ForrestKang/fpga-line-laser-3d-measurement/report/ai_collaboration_records.md

# 智能体协作记录

以下保留任务片段、响应摘要、纠错过程和可复核产物；响应摘要用于说明执行思路，不作为逐字对话记录。

## 工程复现与参考结果比对

提示词片段：“软件跟固件配套核对清楚，测试也跑完整，再重新打包给我人工检查。”

响应摘要：先整理源码与恢复映射，再从解包目录执行测试，按接口合同检查帧身份、字段、顺序、单位与参考结果，保留错误输入和结果。

自我纠错：不能只凭输出非空判断正确，也不能排序后掩盖协议顺序变化。将输入、比较字段和容限写清楚，逐项区分结果差异、接口差异与运行环境问题。

可复核产物：[源码恢复入口](../build/restore_sources.py)、[完整软件测试](../sim/run_release_tests.py)、[软件与固件接口测试](../sim/test_release_pairing.py)和[通用工作流](../skill/readme.md)。

## 报告图形与交付包纠错

提示词片段：“帮我把代码修改好，还有我的报告中这一页pdf是什么情况。”

响应摘要：核对原始图形与PDF中的公式、编号和箭头，定位嵌入矢量图在导出器中的兼容问题；改用原图的高分辨率预览嵌入，保留配色、公式内容和测量数值，再渲染检查。

自我纠错：不能仅凭正文提取和缩略图判断PDF正确；需要查看最终页面的公式与文字。工程包也不能只保留程序文件，必须按提交指南同时带上仿真、实现报告、板端结果和复现脚本。

可复核产物：[技术报告](design_report.pdf)、[完整构建入口](../build/reproduce.py)、[验证汇总](release_validation.json)。

## 工作流与经验提炼

实际采用“输入与接口确认→参考模型/冻结结果→实现→差分与故障测试→解包复现→交付”的流程。独立子任务可以并行检查，集成和单板执行保持唯一负责人。智能体负责代码阅读、脚本组织与报告分析，位宽、缓存所有权、错误拒绝和时序结论由对应测试与工具报告确认。

通用技能从DMA等待与中断、缓存所有权、参考结果错序和性能计时混用中提炼；验证方法、效果与边界见[技能提炼](skill_development.md)和[技能入口](../skill/readme.md)。
