ForrestKang/fpga-line-laser-3d-measurement/board/historical_outputs/scan_models_20261031/astro_views.png

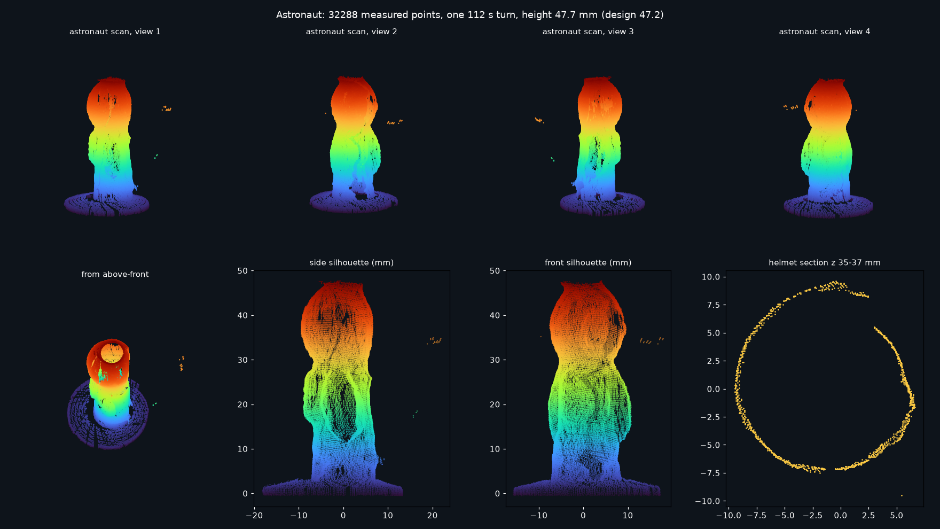
board/historical_outputs/scan_models_20261031/astro_views.png
