ForrestKang/fpga-line-laser-3d-measurement/board/historical_outputs/scan_models_20261031/meshes.png

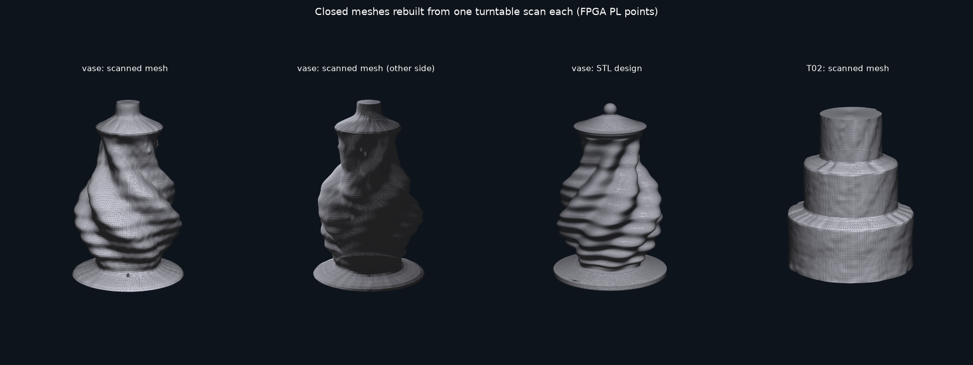
board/historical_outputs/scan_models_20261031/meshes.png
