ForrestKang/fpga-line-laser-3d-measurement/build/evidence/reports/cdc_constraint_inventory.txt

cam_fault_sync1 expected_D=1 actual_D=1
  DEST_D bd_i/processing_pipeline/inst/u_ip/u_core/cam_fault_sync1_reg/D
cam_fault_sync1 TIMED_D bd_i/processing_pipeline/inst/u_ip/u_core/cam_fault_sync1_reg/D Q=bd_i/processing_pipeline/inst/u_ip/u_core/cam_fault_reg/Q C=bd_i/processing_pipeline/inst/u_ip/u_core/cam_fault_reg/C
cam_fault_sync1 source_clock=cam_pclk destination_clock=clk_fpga_0  D=1 timed_D=1 source_Q=1  timing_start_C=1 constants=0 local_feedback=0  max_delay_ns=10 bus_skew=0
cam_fault_flags_sync1 expected_D=16 actual_D=16
  DEST_D bd_i/processing_pipeline/inst/u_ip/u_core/cam_fault_flags_sync1_reg[0]/D
  DEST_D bd_i/processing_pipeline/inst/u_ip/u_core/cam_fault_flags_sync1_reg[10]/D
  DEST_D bd_i/processing_pipeline/inst/u_ip/u_core/cam_fault_flags_sync1_reg[11]/D
  DEST_D bd_i/processing_pipeline/inst/u_ip/u_core/cam_fault_flags_sync1_reg[12]/D
  DEST_D bd_i/processing_pipeline/inst/u_ip/u_core/cam_fault_flags_sync1_reg[13]/D
  DEST_D bd_i/processing_pipeline/inst/u_ip/u_core/cam_fault_flags_sync1_reg[14]/D
  DEST_D bd_i/processing_pipeline/inst/u_ip/u_core/cam_fault_flags_sync1_reg[15]/D
  DEST_D bd_i/processing_pipeline/inst/u_ip/u_core/cam_fault_flags_sync1_reg[1]/D
  DEST_D bd_i/processing_pipeline/inst/u_ip/u_core/cam_fault_flags_sync1_reg[2]/D
  DEST_D bd_i/processing_pipeline/inst/u_ip/u_core/cam_fault_flags_sync1_reg[3]/D
  DEST_D bd_i/processing_pipeline/inst/u_ip/u_core/cam_fault_flags_sync1_reg[4]/D
  DEST_D bd_i/processing_pipeline/inst/u_ip/u_core/cam_fault_flags_sync1_reg[5]/D
  DEST_D bd_i/processing_pipeline/inst/u_ip/u_core/cam_fault_flags_sync1_reg[6]/D
  DEST_D bd_i/processing_pipeline/inst/u_ip/u_core/cam_fault_flags_sync1_reg[7]/D
  DEST_D bd_i/processing_pipeline/inst/u_ip/u_core/cam_fault_flags_sync1_reg[8]/D
  DEST_D bd_i/processing_pipeline/inst/u_ip/u_core/cam_fault_flags_sync1_reg[9]/D
cam_fault_flags_sync1 CONSTANT_D bd_i/processing_pipeline/inst/u_ip/u_core/cam_fault_flags_sync1_reg[0]/D GND bd_i/processing_pipeline/inst/u_ip/u_core/GND/G
cam_fault_flags_sync1 CONSTANT_D bd_i/processing_pipeline/inst/u_ip/u_core/cam_fault_flags_sync1_reg[10]/D GND bd_i/processing_pipeline/inst/u_ip/u_core/GND/G
cam_fault_flags_sync1 CONSTANT_D bd_i/processing_pipeline/inst/u_ip/u_core/cam_fault_flags_sync1_reg[11]/D GND bd_i/processing_pipeline/inst/u_ip/u_core/GND/G
cam_fault_flags_sync1 CONSTANT_D bd_i/processing_pipeline/inst/u_ip/u_core/cam_fault_flags_sync1_reg[12]/D GND bd_i/processing_pipeline/inst/u_ip/u_core/GND/G
cam_fault_flags_sync1 CONSTANT_D bd_i/processing_pipeline/inst/u_ip/u_core/cam_fault_flags_sync1_reg[13]/D GND bd_i/processing_pipeline/inst/u_ip/u_core/GND/G
cam_fault_flags_sync1 CONSTANT_D bd_i/processing_pipeline/inst/u_ip/u_core/cam_fault_flags_sync1_reg[14]/D GND bd_i/processing_pipeline/inst/u_ip/u_core/GND/G
cam_fault_flags_sync1 CONSTANT_D bd_i/processing_pipeline/inst/u_ip/u_core/cam_fault_flags_sync1_reg[15]/D GND bd_i/processing_pipeline/inst/u_ip/u_core/GND/G
cam_fault_flags_sync1 TIMED_D bd_i/processing_pipeline/inst/u_ip/u_core/cam_fault_flags_sync1_reg[1]/D Q=bd_i/processing_pipeline/inst/u_ip/u_core/cam_fault_flags_reg[1]/Q C=bd_i/processing_pipeline/inst/u_ip/u_core/cam_fault_flags_reg[1]/C
cam_fault_flags_sync1 TIMED_D bd_i/processing_pipeline/inst/u_ip/u_core/cam_fault_flags_sync1_reg[2]/D Q=bd_i/processing_pipeline/inst/u_ip/u_core/cam_fault_flags_reg[2]/Q C=bd_i/processing_pipeline/inst/u_ip/u_core/cam_fault_flags_reg[2]/C
cam_fault_flags_sync1 TIMED_D bd_i/processing_pipeline/inst/u_ip/u_core/cam_fault_flags_sync1_reg[3]/D Q=bd_i/processing_pipeline/inst/u_ip/u_core/cam_fault_flags_reg[3]/Q C=bd_i/processing_pipeline/inst/u_ip/u_core/cam_fault_flags_reg[3]/C
cam_fault_flags_sync1 CONSTANT_D bd_i/processing_pipeline/inst/u_ip/u_core/cam_fault_flags_sync1_reg[4]/D GND bd_i/processing_pipeline/inst/u_ip/u_core/GND/G
cam_fault_flags_sync1 TIMED_D bd_i/processing_pipeline/inst/u_ip/u_core/cam_fault_flags_sync1_reg[5]/D Q=bd_i/processing_pipeline/inst/u_ip/u_core/cam_fault_flags_reg[5]/Q C=bd_i/processing_pipeline/inst/u_ip/u_core/cam_fault_flags_reg[5]/C
cam_fault_flags_sync1 CONSTANT_D bd_i/processing_pipeline/inst/u_ip/u_core/cam_fault_flags_sync1_reg[6]/D GND bd_i/processing_pipeline/inst/u_ip/u_core/GND/G
cam_fault_flags_sync1 CONSTANT_D bd_i/processing_pipeline/inst/u_ip/u_core/cam_fault_flags_sync1_reg[7]/D GND bd_i/processing_pipeline/inst/u_ip/u_core/GND/G
cam_fault_flags_sync1 CONSTANT_D bd_i/processing_pipeline/inst/u_ip/u_core/cam_fault_flags_sync1_reg[8]/D GND bd_i/processing_pipeline/inst/u_ip/u_core/GND/G
cam_fault_flags_sync1 CONSTANT_D bd_i/processing_pipeline/inst/u_ip/u_core/cam_fault_flags_sync1_reg[9]/D GND bd_i/processing_pipeline/inst/u_ip/u_core/GND/G
cam_fault_flags_sync1 source_clock=cam_pclk destination_clock=clk_fpga_0  D=16 timed_D=4 source_Q=4  timing_start_C=4 constants=12 local_feedback=0  max_delay_ns=10 bus_skew=10
cam_frame_count_sync1 expected_D=16 actual_D=16
  DEST_D bd_i/processing_pipeline/inst/u_ip/u_core/cam_frame_count_sync1_reg[0]/D
  DEST_D bd_i/processing_pipeline/inst/u_ip/u_core/cam_frame_count_sync1_reg[10]/D
  DEST_D bd_i/processing_pipeline/inst/u_ip/u_core/cam_frame_count_sync1_reg[11]/D
  DEST_D bd_i/processing_pipeline/inst/u_ip/u_core/cam_frame_count_sync1_reg[12]/D
  DEST_D bd_i/processing_pipeline/inst/u_ip/u_core/cam_frame_count_sync1_reg[13]/D
  DEST_D bd_i/processing_pipeline/inst/u_ip/u_core/cam_frame_count_sync1_reg[14]/D
  DEST_D bd_i/processing_pipeline/inst/u_ip/u_core/cam_frame_count_sync1_reg[15]/D
  DEST_D bd_i/processing_pipeline/inst/u_ip/u_core/cam_frame_count_sync1_reg[1]/D
  DEST_D bd_i/processing_pipeline/inst/u_ip/u_core/cam_frame_count_sync1_reg[2]/D
  DEST_D bd_i/processing_pipeline/inst/u_ip/u_core/cam_frame_count_sync1_reg[3]/D
  DEST_D bd_i/processing_pipeline/inst/u_ip/u_core/cam_frame_count_sync1_reg[4]/D
  DEST_D bd_i/processing_pipeline/inst/u_ip/u_core/cam_frame_count_sync1_reg[5]/D
  DEST_D bd_i/processing_pipeline/inst/u_ip/u_core/cam_frame_count_sync1_reg[6]/D
  DEST_D bd_i/processing_pipeline/inst/u_ip/u_core/cam_frame_count_sync1_reg[7]/D
  DEST_D bd_i/processing_pipeline/inst/u_ip/u_core/cam_frame_count_sync1_reg[8]/D
  DEST_D bd_i/processing_pipeline/inst/u_ip/u_core/cam_frame_count_sync1_reg[9]/D
cam_frame_count_sync1 TIMED_D bd_i/processing_pipeline/inst/u_ip/u_core/cam_frame_count_sync1_reg[0]/D Q=bd_i/processing_pipeline/inst/u_ip/u_core/cam_frame_count_gray_reg[0]/Q C=bd_i/processing_pipeline/inst/u_ip/u_core/cam_frame_count_gray_reg[0]/C
cam_frame_count_sync1 TIMED_D bd_i/processing_pipeline/inst/u_ip/u_core/cam_frame_count_sync1_reg[10]/D Q=bd_i/processing_pipeline/inst/u_ip/u_core/cam_frame_count_gray_reg[10]/Q C=bd_i/processing_pipeline/inst/u_ip/u_core/cam_frame_count_gray_reg[10]/C
cam_frame_count_sync1 TIMED_D bd_i/processing_pipeline/inst/u_ip/u_core/cam_frame_count_sync1_reg[11]/D Q=bd_i/processing_pipeline/inst/u_ip/u_core/cam_frame_count_gray_reg[11]/Q C=bd_i/processing_pipeline/inst/u_ip/u_core/cam_frame_count_gray_reg[11]/C
cam_frame_count_sync1 TIMED_D bd_i/processing_pipeline/inst/u_ip/u_core/cam_frame_count_sync1_reg[12]/D Q=bd_i/processing_pipeline/inst/u_ip/u_core/cam_frame_count_gray_reg[12]/Q C=bd_i/processing_pipeline/inst/u_ip/u_core/cam_frame_count_gray_reg[12]/C
cam_frame_count_sync1 TIMED_D bd_i/processing_pipeline/inst/u_ip/u_core/cam_frame_count_sync1_reg[13]/D Q=bd_i/processing_pipeline/inst/u_ip/u_core/cam_frame_count_gray_reg[13]/Q C=bd_i/processing_pipeline/inst/u_ip/u_core/cam_frame_count_gray_reg[13]/C
cam_frame_count_sync1 TIMED_D bd_i/processing_pipeline/inst/u_ip/u_core/cam_frame_count_sync1_reg[14]/D Q=bd_i/processing_pipeline/inst/u_ip/u_core/cam_frame_count_gray_reg[14]/Q C=bd_i/processing_pipeline/inst/u_ip/u_core/cam_frame_count_gray_reg[14]/C
cam_frame_count_sync1 TIMED_D bd_i/processing_pipeline/inst/u_ip/u_core/cam_frame_count_sync1_reg[15]/D Q=bd_i/processing_pipeline/inst/u_ip/u_core/cam_frame_count_gray_reg[15]/Q C=bd_i/processing_pipeline/inst/u_ip/u_core/cam_frame_count_gray_reg[15]/C
cam_frame_count_sync1 TIMED_D bd_i/processing_pipeline/inst/u_ip/u_core/cam_frame_count_sync1_reg[1]/D Q=bd_i/processing_pipeline/inst/u_ip/u_core/cam_frame_count_gray_reg[1]/Q C=bd_i/processing_pipeline/inst/u_ip/u_core/cam_frame_count_gray_reg[1]/C
cam_frame_count_sync1 TIMED_D bd_i/processing_pipeline/inst/u_ip/u_core/cam_frame_count_sync1_reg[2]/D Q=bd_i/processing_pipeline/inst/u_ip/u_core/cam_frame_count_gray_reg[2]/Q C=bd_i/processing_pipeline/inst/u_ip/u_core/cam_frame_count_gray_reg[2]/C
cam_frame_count_sync1 TIMED_D bd_i/processing_pipeline/inst/u_ip/u_core/cam_frame_count_sync1_reg[3]/D Q=bd_i/processing_pipeline/inst/u_ip/u_core/cam_frame_count_gray_reg[3]/Q C=bd_i/processing_pipeline/inst/u_ip/u_core/cam_frame_count_gray_reg[3]/C
cam_frame_count_sync1 TIMED_D bd_i/processing_pipeline/inst/u_ip/u_core/cam_frame_count_sync1_reg[4]/D Q=bd_i/processing_pipeline/inst/u_ip/u_core/cam_frame_count_gray_reg[4]/Q C=bd_i/processing_pipeline/inst/u_ip/u_core/cam_frame_count_gray_reg[4]/C
cam_frame_count_sync1 TIMED_D bd_i/processing_pipeline/inst/u_ip/u_core/cam_frame_count_sync1_reg[5]/D Q=bd_i/processing_pipeline/inst/u_ip/u_core/cam_frame_count_gray_reg[5]/Q C=bd_i/processing_pipeline/inst/u_ip/u_core/cam_frame_count_gray_reg[5]/C
cam_frame_count_sync1 TIMED_D bd_i/processing_pipeline/inst/u_ip/u_core/cam_frame_count_sync1_reg[6]/D Q=bd_i/processing_pipeline/inst/u_ip/u_core/cam_frame_count_gray_reg[6]/Q C=bd_i/processing_pipeline/inst/u_ip/u_core/cam_frame_count_gray_reg[6]/C
cam_frame_count_sync1 TIMED_D bd_i/processing_pipeline/inst/u_ip/u_core/cam_frame_count_sync1_reg[7]/D Q=bd_i/processing_pipeline/inst/u_ip/u_core/cam_frame_count_gray_reg[7]/Q C=bd_i/processing_pipeline/inst/u_ip/u_core/cam_frame_count_gray_reg[7]/C
cam_frame_count_sync1 TIMED_D bd_i/processing_pipeline/inst/u_ip/u_core/cam_frame_count_sync1_reg[8]/D Q=bd_i/processing_pipeline/inst/u_ip/u_core/cam_frame_count_gray_reg[8]/Q C=bd_i/processing_pipeline/inst/u_ip/u_core/cam_frame_count_gray_reg[8]/C
cam_frame_count_sync1 TIMED_D bd_i/processing_pipeline/inst/u_ip/u_core/cam_frame_count_sync1_reg[9]/D Q=bd_i/processing_pipeline/inst/u_ip/u_core/cam_frame_count_gray_reg[9]/Q C=bd_i/processing_pipeline/inst/u_ip/u_core/cam_frame_count_gray_reg[9]/C
cam_frame_count_sync1 source_clock=cam_pclk destination_clock=clk_fpga_0  D=16 timed_D=16 source_Q=16  timing_start_C=16 constants=0 local_feedback=0  max_delay_ns=10 bus_skew=10
geometry_toggle_sync1 expected_D=1 actual_D=1
  DEST_D bd_i/processing_pipeline/inst/u_ip/u_core/geometry_toggle_sync1_reg/D
geometry_toggle_sync1 TIMED_D bd_i/processing_pipeline/inst/u_ip/u_core/geometry_toggle_sync1_reg/D Q=bd_i/processing_pipeline/inst/u_ip/u_core/cam_geometry_toggle_reg/Q C=bd_i/processing_pipeline/inst/u_ip/u_core/cam_geometry_toggle_reg/C
geometry_toggle_sync1 source_clock=cam_pclk destination_clock=clk_fpga_0  D=1 timed_D=1 source_Q=1  timing_start_C=1 constants=0 local_feedback=0  max_delay_ns=10 bus_skew=0
geometry_line_sync1 expected_D=32 actual_D=32
  DEST_D bd_i/processing_pipeline/inst/u_ip/u_core/geometry_line_sync1_reg[0]/D
  DEST_D bd_i/processing_pipeline/inst/u_ip/u_core/geometry_line_sync1_reg[10]/D
  DEST_D bd_i/processing_pipeline/inst/u_ip/u_core/geometry_line_sync1_reg[11]/D
  DEST_D bd_i/processing_pipeline/inst/u_ip/u_core/geometry_line_sync1_reg[12]/D
  DEST_D bd_i/processing_pipeline/inst/u_ip/u_core/geometry_line_sync1_reg[13]/D
  DEST_D bd_i/processing_pipeline/inst/u_ip/u_core/geometry_line_sync1_reg[14]/D
  DEST_D bd_i/processing_pipeline/inst/u_ip/u_core/geometry_line_sync1_reg[15]/D
  DEST_D bd_i/processing_pipeline/inst/u_ip/u_core/geometry_line_sync1_reg[16]/D
  DEST_D bd_i/processing_pipeline/inst/u_ip/u_core/geometry_line_sync1_reg[17]/D
  DEST_D bd_i/processing_pipeline/inst/u_ip/u_core/geometry_line_sync1_reg[18]/D
  DEST_D bd_i/processing_pipeline/inst/u_ip/u_core/geometry_line_sync1_reg[19]/D
  DEST_D bd_i/processing_pipeline/inst/u_ip/u_core/geometry_line_sync1_reg[1]/D
  DEST_D bd_i/processing_pipeline/inst/u_ip/u_core/geometry_line_sync1_reg[20]/D
  DEST_D bd_i/processing_pipeline/inst/u_ip/u_core/geometry_line_sync1_reg[21]/D
  DEST_D bd_i/processing_pipeline/inst/u_ip/u_core/geometry_line_sync1_reg[22]/D
  DEST_D bd_i/processing_pipeline/inst/u_ip/u_core/geometry_line_sync1_reg[23]/D
  DEST_D bd_i/processing_pipeline/inst/u_ip/u_core/geometry_line_sync1_reg[24]/D
  DEST_D bd_i/processing_pipeline/inst/u_ip/u_core/geometry_line_sync1_reg[25]/D
  DEST_D bd_i/processing_pipeline/inst/u_ip/u_core/geometry_line_sync1_reg[26]/D
  DEST_D bd_i/processing_pipeline/inst/u_ip/u_core/geometry_line_sync1_reg[27]/D
  DEST_D bd_i/processing_pipeline/inst/u_ip/u_core/geometry_line_sync1_reg[28]/D
  DEST_D bd_i/processing_pipeline/inst/u_ip/u_core/geometry_line_sync1_reg[29]/D
  DEST_D bd_i/processing_pipeline/inst/u_ip/u_core/geometry_line_sync1_reg[2]/D
  DEST_D bd_i/processing_pipeline/inst/u_ip/u_core/geometry_line_sync1_reg[30]/D
  DEST_D bd_i/processing_pipeline/inst/u_ip/u_core/geometry_line_sync1_reg[31]/D
  DEST_D bd_i/processing_pipeline/inst/u_ip/u_core/geometry_line_sync1_reg[3]/D
  DEST_D bd_i/processing_pipeline/inst/u_ip/u_core/geometry_line_sync1_reg[4]/D
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
geometry_line_sync1 TIMED_D bd_i/processing_pipeline/inst/u_ip/u_core/geometry_line_sync1_reg[5]/D Q=bd_i/processing_pipeline/inst/u_ip/u_core/cam_line_mailbox_reg[5]/Q C=bd_i/processing_pipeline/inst/u_ip/u_core/cam_line_mailbox_reg[5]/C
geometry_line_sync1 TIMED_D bd_i/processing_pipeline/inst/u_ip/u_core/geometry_line_sync1_reg[6]/D Q=bd_i/processing_pipeline/inst/u_ip/u_core/cam_line_mailbox_reg[6]/Q C=bd_i/processing_pipeline/inst/u_ip/u_core/cam_line_mailbox_reg[6]/C
geometry_line_sync1 TIMED_D bd_i/processing_pipeline/inst/u_ip/u_core/geometry_line_sync1_reg[7]/D Q=bd_i/processing_pipeline/inst/u_ip/u_core/cam_line_mailbox_reg[7]/Q C=bd_i/processing_pipeline/inst/u_ip/u_core/cam_line_mailbox_reg[7]/C
geometry_line_sync1 TIMED_D bd_i/processing_pipeline/inst/u_ip/u_core/geometry_line_sync1_reg[8]/D Q=bd_i/processing_pipeline/inst/u_ip/u_core/cam_line_mailbox_reg[8]/Q C=bd_i/processing_pipeline/inst/u_ip/u_core/cam_line_mailbox_reg[8]/C
geometry_line_sync1 TIMED_D bd_i/processing_pipeline/inst/u_ip/u_core/geometry_line_sync1_reg[9]/D Q=bd_i/processing_pipeline/inst/u_ip/u_core/cam_line_mailbox_reg[9]/Q C=bd_i/processing_pipeline/inst/u_ip/u_core/cam_line_mailbox_reg[9]/C
geometry_line_sync1 source_clock=cam_pclk destination_clock=clk_fpga_0  D=32 timed_D=32 source_Q=32  timing_start_C=32 constants=0 local_feedback=0  max_delay_ns=10 bus_skew=10
geometry_frame_sync1 expected_D=11 actual_D=11
  DEST_D bd_i/processing_pipeline/inst/u_ip/u_core/geometry_frame_sync1_reg[0]/D
  DEST_D bd_i/processing_pipeline/inst/u_ip/u_core/geometry_frame_sync1_reg[10]/D
  DEST_D bd_i/processing_pipeline/inst/u_ip/u_core/geometry_frame_sync1_reg[1]/D
  DEST_D bd_i/processing_pipeline/inst/u_ip/u_core/geometry_frame_sync1_reg[2]/D
  DEST_D bd_i/processing_pipeline/inst/u_ip/u_core/geometry_frame_sync1_reg[3]/D
  DEST_D bd_i/processing_pipeline/inst/u_ip/u_core/geometry_frame_sync1_reg[4]/D
  DEST_D bd_i/processing_pipeline/inst/u_ip/u_core/geometry_frame_sync1_reg[5]/D
  DEST_D bd_i/processing_pipeline/inst/u_ip/u_core/geometry_frame_sync1_reg[6]/D
  DEST_D bd_i/processing_pipeline/inst/u_ip/u_core/geometry_frame_sync1_reg[7]/D
  DEST_D bd_i/processing_pipeline/inst/u_ip/u_core/geometry_frame_sync1_reg[8]/D
  DEST_D bd_i/processing_pipeline/inst/u_ip/u_core/geometry_frame_sync1_reg[9]/D
geometry_frame_sync1 TIMED_D bd_i/processing_pipeline/inst/u_ip/u_core/geometry_frame_sync1_reg[0]/D Q=bd_i/processing_pipeline/inst/u_ip/u_core/cam_frame_lines_mailbox_reg[0]/Q C=bd_i/processing_pipeline/inst/u_ip/u_core/cam_frame_lines_mailbox_reg[0]/C
geometry_frame_sync1 TIMED_D bd_i/processing_pipeline/inst/u_ip/u_core/geometry_frame_sync1_reg[10]/D Q=bd_i/processing_pipeline/inst/u_ip/u_core/cam_frame_lines_mailbox_reg[10]/Q C=bd_i/processing_pipeline/inst/u_ip/u_core/cam_frame_lines_mailbox_reg[10]/C
geometry_frame_sync1 TIMED_D bd_i/processing_pipeline/inst/u_ip/u_core/geometry_frame_sync1_reg[1]/D Q=bd_i/processing_pipeline/inst/u_ip/u_core/cam_frame_lines_mailbox_reg[1]/Q C=bd_i/processing_pipeline/inst/u_ip/u_core/cam_frame_lines_mailbox_reg[1]/C
geometry_frame_sync1 TIMED_D bd_i/processing_pipeline/inst/u_ip/u_core/geometry_frame_sync1_reg[2]/D Q=bd_i/processing_pipeline/inst/u_ip/u_core/cam_frame_lines_mailbox_reg[2]/Q C=bd_i/processing_pipeline/inst/u_ip/u_core/cam_frame_lines_mailbox_reg[2]/C
geometry_frame_sync1 TIMED_D bd_i/processing_pipeline/inst/u_ip/u_core/geometry_frame_sync1_reg[3]/D Q=bd_i/processing_pipeline/inst/u_ip/u_core/cam_frame_lines_mailbox_reg[3]/Q C=bd_i/processing_pipeline/inst/u_ip/u_core/cam_frame_lines_mailbox_reg[3]/C
geometry_frame_sync1 TIMED_D bd_i/processing_pipeline/inst/u_ip/u_core/geometry_frame_sync1_reg[4]/D Q=bd_i/processing_pipeline/inst/u_ip/u_core/cam_frame_lines_mailbox_reg[4]/Q C=bd_i/processing_pipeline/inst/u_ip/u_core/cam_frame_lines_mailbox_reg[4]/C
geometry_frame_sync1 TIMED_D bd_i/processing_pipeline/inst/u_ip/u_core/geometry_frame_sync1_reg[5]/D Q=bd_i/processing_pipeline/inst/u_ip/u_core/cam_frame_lines_mailbox_reg[5]/Q C=bd_i/processing_pipeline/inst/u_ip/u_core/cam_frame_lines_mailbox_reg[5]/C
geometry_frame_sync1 TIMED_D bd_i/processing_pipeline/inst/u_ip/u_core/geometry_frame_sync1_reg[6]/D Q=bd_i/processing_pipeline/inst/u_ip/u_core/cam_frame_lines_mailbox_reg[6]/Q C=bd_i/processing_pipeline/inst/u_ip/u_core/cam_frame_lines_mailbox_reg[6]/C
geometry_frame_sync1 TIMED_D bd_i/processing_pipeline/inst/u_ip/u_core/geometry_frame_sync1_reg[7]/D Q=bd_i/processing_pipeline/inst/u_ip/u_core/cam_frame_lines_mailbox_reg[7]/Q C=bd_i/processing_pipeline/inst/u_ip/u_core/cam_frame_lines_mailbox_reg[7]/C
geometry_frame_sync1 TIMED_D bd_i/processing_pipeline/inst/u_ip/u_core/geometry_frame_sync1_reg[8]/D Q=bd_i/processing_pipeline/inst/u_ip/u_core/cam_frame_lines_mailbox_reg[8]/Q C=bd_i/processing_pipeline/inst/u_ip/u_core/cam_frame_lines_mailbox_reg[8]/C
geometry_frame_sync1 TIMED_D bd_i/processing_pipeline/inst/u_ip/u_core/geometry_frame_sync1_reg[9]/D Q=bd_i/processing_pipeline/inst/u_ip/u_core/cam_frame_lines_mailbox_reg[9]/Q C=bd_i/processing_pipeline/inst/u_ip/u_core/cam_frame_lines_mailbox_reg[9]/C
geometry_frame_sync1 source_clock=cam_pclk destination_clock=clk_fpga_0  D=11 timed_D=11 source_Q=11  timing_start_C=11 constants=0 local_feedback=0  max_delay_ns=10 bus_skew=10
geometry_eof_sync1 expected_D=5 actual_D=5
  DEST_D bd_i/processing_pipeline/inst/u_ip/u_core/geometry_eof_sync1_reg[0]/D
  DEST_D bd_i/processing_pipeline/inst/u_ip/u_core/geometry_eof_sync1_reg[1]/D
  DEST_D bd_i/processing_pipeline/inst/u_ip/u_core/geometry_eof_sync1_reg[2]/D
  DEST_D bd_i/processing_pipeline/inst/u_ip/u_core/geometry_eof_sync1_reg[3]/D
  DEST_D bd_i/processing_pipeline/inst/u_ip/u_core/geometry_eof_sync1_reg[4]/D
geometry_eof_sync1 TIMED_D bd_i/processing_pipeline/inst/u_ip/u_core/geometry_eof_sync1_reg[0]/D Q=bd_i/processing_pipeline/inst/u_ip/u_core/cam_eof_errors_mailbox_reg[0]/Q C=bd_i/processing_pipeline/inst/u_ip/u_core/cam_eof_errors_mailbox_reg[0]/C
geometry_eof_sync1 TIMED_D bd_i/processing_pipeline/inst/u_ip/u_core/geometry_eof_sync1_reg[1]/D Q=bd_i/processing_pipeline/inst/u_ip/u_core/cam_eof_errors_mailbox_reg[1]/Q C=bd_i/processing_pipeline/inst/u_ip/u_core/cam_eof_errors_mailbox_reg[1]/C
geometry_eof_sync1 TIMED_D bd_i/processing_pipeline/inst/u_ip/u_core/geometry_eof_sync1_reg[2]/D Q=bd_i/processing_pipeline/inst/u_ip/u_core/cam_eof_errors_mailbox_reg[2]/Q C=bd_i/processing_pipeline/inst/u_ip/u_core/cam_eof_errors_mailbox_reg[2]/C
geometry_eof_sync1 TIMED_D bd_i/processing_pipeline/inst/u_ip/u_core/geometry_eof_sync1_reg[3]/D Q=bd_i/processing_pipeline/inst/u_ip/u_core/cam_eof_errors_mailbox_reg[3]/Q C=bd_i/processing_pipeline/inst/u_ip/u_core/cam_eof_errors_mailbox_reg[3]/C
geometry_eof_sync1 TIMED_D bd_i/processing_pipeline/inst/u_ip/u_core/geometry_eof_sync1_reg[4]/D Q=bd_i/processing_pipeline/inst/u_ip/u_core/cam_eof_errors_mailbox_reg[4]/Q C=bd_i/processing_pipeline/inst/u_ip/u_core/cam_eof_errors_mailbox_reg[4]/C
geometry_eof_sync1 source_clock=cam_pclk destination_clock=clk_fpga_0  D=5 timed_D=5 source_Q=5  timing_start_C=5 constants=0 local_feedback=0  max_delay_ns=10 bus_skew=10
cam_global_reset_sync1 expected_D=1 actual_D=1
  DEST_D bd_i/processing_pipeline/inst/u_ip/u_core/cam_global_reset_sync1_reg/D
cam_global_reset_sync1 TIMED_D bd_i/processing_pipeline/inst/u_ip/u_core/cam_global_reset_sync1_reg/D Q=bd_i/processing_pipeline/inst/u_ip/u_core/g_camera_reset_xpm.u_capture_global_reset/arststages_ff_reg[1]/Q C=bd_i/processing_pipeline/inst/u_ip/u_core/g_camera_reset_xpm.u_capture_global_reset/arststages_ff_reg[1]/C
cam_global_reset_sync1 source_clock=cam_pclk destination_clock=clk_fpga_0  D=1 timed_D=1 source_Q=1  timing_start_C=1 constants=0 local_feedback=0  max_delay_ns=10 bus_skew=0
cam_flush_reset_sync1 expected_D=1 actual_D=1
  DEST_D bd_i/processing_pipeline/inst/u_ip/u_core/cam_flush_reset_sync1_reg/D
cam_flush_reset_sync1 TIMED_D bd_i/processing_pipeline/inst/u_ip/u_core/cam_flush_reset_sync1_reg/D Q=bd_i/processing_pipeline/inst/u_ip/u_core/g_camera_reset_xpm.u_capture_reset/arststages_ff_reg[3]/Q C=bd_i/processing_pipeline/inst/u_ip/u_core/g_camera_reset_xpm.u_capture_reset/arststages_ff_reg[3]/C
cam_flush_reset_sync1 source_clock=cam_pclk destination_clock=clk_fpga_0  D=1 timed_D=1 source_Q=1  timing_start_C=1 constants=0 local_feedback=0  max_delay_ns=10 bus_skew=0
request_toggle_first_stage expected_D=1 actual_D=1
  DEST_D bd_i/processing_pipeline/inst/u_ip/u_core/req_sync1_reg/D
request_toggle TIMED_D bd_i/processing_pipeline/inst/u_ip/u_core/req_sync1_reg/D Q=bd_i/processing_pipeline/inst/u_ip/u_core/request_toggle_reg/Q C=bd_i/processing_pipeline/inst/u_ip/u_core/request_toggle_reg/C
request_toggle source_clock=clk_fpga_0 destination_clock=cam_pclk  D=1 timed_D=1 source_Q=1  timing_start_C=1 constants=0 local_feedback=0  max_delay_ns=10 bus_skew=0
held_configuration_mailbox expected_D=48 actual_D=48
  DEST_D bd_i/processing_pipeline/inst/u_ip/u_core/cam_epoch_reg[0]/D
  DEST_D bd_i/processing_pipeline/inst/u_ip/u_core/cam_epoch_reg[10]/D
  DEST_D bd_i/processing_pipeline/inst/u_ip/u_core/cam_epoch_reg[11]/D
  DEST_D bd_i/processing_pipeline/inst/u_ip/u_core/cam_epoch_reg[12]/D
  DEST_D bd_i/processing_pipeline/inst/u_ip/u_core/cam_epoch_reg[13]/D
  DEST_D bd_i/processing_pipeline/inst/u_ip/u_core/cam_epoch_reg[14]/D
  DEST_D bd_i/processing_pipeline/inst/u_ip/u_core/cam_epoch_reg[15]/D
  DEST_D bd_i/processing_pipeline/inst/u_ip/u_core/cam_epoch_reg[1]/D
  DEST_D bd_i/processing_pipeline/inst/u_ip/u_core/cam_epoch_reg[2]/D
  DEST_D bd_i/processing_pipeline/inst/u_ip/u_core/cam_epoch_reg[3]/D
  DEST_D bd_i/processing_pipeline/inst/u_ip/u_core/cam_epoch_reg[4]/D
  DEST_D bd_i/processing_pipeline/inst/u_ip/u_core/cam_epoch_reg[5]/D
  DEST_D bd_i/processing_pipeline/inst/u_ip/u_core/cam_epoch_reg[6]/D
  DEST_D bd_i/processing_pipeline/inst/u_ip/u_core/cam_epoch_reg[7]/D
  DEST_D bd_i/processing_pipeline/inst/u_ip/u_core/cam_epoch_reg[8]/D
  DEST_D bd_i/processing_pipeline/inst/u_ip/u_core/cam_epoch_reg[9]/D
  DEST_D bd_i/processing_pipeline/inst/u_ip/u_core/cam_profile_id_reg[0]/D
  DEST_D bd_i/processing_pipeline/inst/u_ip/u_core/cam_profile_id_reg[10]/D
  DEST_D bd_i/processing_pipeline/inst/u_ip/u_core/cam_profile_id_reg[11]/D
  DEST_D bd_i/processing_pipeline/inst/u_ip/u_core/cam_profile_id_reg[12]/D
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
configuration_mailbox TIMED_D bd_i/processing_pipeline/inst/u_ip/u_core/cam_profile_id_reg[28]/D Q=bd_i/processing_pipeline/inst/u_ip/u_core/profile_id_reg[28]/Q C=bd_i/processing_pipeline/inst/u_ip/u_core/profile_id_reg[28]/C
configuration_mailbox TIMED_D bd_i/processing_pipeline/inst/u_ip/u_core/cam_profile_id_reg[29]/D Q=bd_i/processing_pipeline/inst/u_ip/u_core/profile_id_reg[29]/Q C=bd_i/processing_pipeline/inst/u_ip/u_core/profile_id_reg[29]/C
configuration_mailbox TIMED_D bd_i/processing_pipeline/inst/u_ip/u_core/cam_profile_id_reg[2]/D Q=bd_i/processing_pipeline/inst/u_ip/u_core/profile_id_reg[2]/Q C=bd_i/processing_pipeline/inst/u_ip/u_core/profile_id_reg[2]/C
configuration_mailbox TIMED_D bd_i/processing_pipeline/inst/u_ip/u_core/cam_profile_id_reg[30]/D Q=bd_i/processing_pipeline/inst/u_ip/u_core/profile_id_reg[30]/Q C=bd_i/processing_pipeline/inst/u_ip/u_core/profile_id_reg[30]/C
configuration_mailbox TIMED_D bd_i/processing_pipeline/inst/u_ip/u_core/cam_profile_id_reg[31]/D Q=bd_i/processing_pipeline/inst/u_ip/u_core/profile_id_reg[31]/Q C=bd_i/processing_pipeline/inst/u_ip/u_core/profile_id_reg[31]/C
configuration_mailbox TIMED_D bd_i/processing_pipeline/inst/u_ip/u_core/cam_profile_id_reg[3]/D Q=bd_i/processing_pipeline/inst/u_ip/u_core/profile_id_reg[3]/Q C=bd_i/processing_pipeline/inst/u_ip/u_core/profile_id_reg[3]/C
configuration_mailbox TIMED_D bd_i/processing_pipeline/inst/u_ip/u_core/cam_profile_id_reg[4]/D Q=bd_i/processing_pipeline/inst/u_ip/u_core/profile_id_reg[4]/Q C=bd_i/processing_pipeline/inst/u_ip/u_core/profile_id_reg[4]/C
configuration_mailbox TIMED_D bd_i/processing_pipeline/inst/u_ip/u_core/cam_profile_id_reg[5]/D Q=bd_i/processing_pipeline/inst/u_ip/u_core/profile_id_reg[5]/Q C=bd_i/processing_pipeline/inst/u_ip/u_core/profile_id_reg[5]/C
configuration_mailbox TIMED_D bd_i/processing_pipeline/inst/u_ip/u_core/cam_profile_id_reg[6]/D Q=bd_i/processing_pipeline/inst/u_ip/u_core/profile_id_reg[6]/Q C=bd_i/processing_pipeline/inst/u_ip/u_core/profile_id_reg[6]/C
configuration_mailbox TIMED_D bd_i/processing_pipeline/inst/u_ip/u_core/cam_profile_id_reg[7]/D Q=bd_i/processing_pipeline/inst/u_ip/u_core/profile_id_reg[7]/Q C=bd_i/processing_pipeline/inst/u_ip/u_core/profile_id_reg[7]/C
configuration_mailbox TIMED_D bd_i/processing_pipeline/inst/u_ip/u_core/cam_profile_id_reg[8]/D Q=bd_i/processing_pipeline/inst/u_ip/u_core/profile_id_reg[8]/Q C=bd_i/processing_pipeline/inst/u_ip/u_core/profile_id_reg[8]/C
configuration_mailbox TIMED_D bd_i/processing_pipeline/inst/u_ip/u_core/cam_profile_id_reg[9]/D Q=bd_i/processing_pipeline/inst/u_ip/u_core/profile_id_reg[9]/Q C=bd_i/processing_pipeline/inst/u_ip/u_core/profile_id_reg[9]/C
configuration_mailbox source_clock=clk_fpga_0 destination_clock=cam_pclk  D=48 timed_D=48 source_Q=48  timing_start_C=48 constants=0 local_feedback=0  max_delay_ns=10 bus_skew=10
metadata_sof_toggle_first_stage expected_D=1 actual_D=1
  DEST_D bd_i/processing_pipeline/inst/u_ip/u_core/u_metadata/toggle_sync1_reg/D
metadata_sof_toggle TIMED_D bd_i/processing_pipeline/inst/u_ip/u_core/u_metadata/toggle_sync1_reg/D Q=bd_i/processing_pipeline/inst/u_ip/u_core/u_metadata/cam_toggle_reg/Q C=bd_i/processing_pipeline/inst/u_ip/u_core/u_metadata/cam_toggle_reg/C
metadata_sof_toggle source_clock=cam_pclk destination_clock=clk_fpga_0  D=1 timed_D=1 source_Q=1  timing_start_C=1 constants=0 local_feedback=0  max_delay_ns=10 bus_skew=0
metadata_sof_identity_mailbox expected_D=48 actual_D=48
  DEST_D bd_i/processing_pipeline/inst/u_ip/u_core/u_metadata/epoch_sync1_reg[0]/D
  DEST_D bd_i/processing_pipeline/inst/u_ip/u_core/u_metadata/epoch_sync1_reg[10]/D
  DEST_D bd_i/processing_pipeline/inst/u_ip/u_core/u_metadata/epoch_sync1_reg[11]/D
  DEST_D bd_i/processing_pipeline/inst/u_ip/u_core/u_metadata/epoch_sync1_reg[12]/D
  DEST_D bd_i/processing_pipeline/inst/u_ip/u_core/u_metadata/epoch_sync1_reg[13]/D
  DEST_D bd_i/processing_pipeline/inst/u_ip/u_core/u_metadata/epoch_sync1_reg[14]/D
  DEST_D bd_i/processing_pipeline/inst/u_ip/u_core/u_metadata/epoch_sync1_reg[15]/D
  DEST_D bd_i/processing_pipeline/inst/u_ip/u_core/u_metadata/epoch_sync1_reg[1]/D
  DEST_D bd_i/processing_pipeline/inst/u_ip/u_core/u_metadata/epoch_sync1_reg[2]/D
  DEST_D bd_i/processing_pipeline/inst/u_ip/u_core/u_metadata/epoch_sync1_reg[3]/D
  DEST_D bd_i/processing_pipeline/inst/u_ip/u_core/u_metadata/epoch_sync1_reg[4]/D
  DEST_D bd_i/processing_pipeline/inst/u_ip/u_core/u_metadata/epoch_sync1_reg[5]/D
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
metadata_sof_identity TIMED_D bd_i/processing_pipeline/inst/u_ip/u_core/u_metadata/id_sync1_reg[29]/D Q=bd_i/processing_pipeline/inst/u_ip/u_core/u_metadata/cam_id_mailbox_reg[29]/Q C=bd_i/processing_pipeline/inst/u_ip/u_core/u_metadata/cam_id_mailbox_reg[29]/C
metadata_sof_identity TIMED_D bd_i/processing_pipeline/inst/u_ip/u_core/u_metadata/id_sync1_reg[2]/D Q=bd_i/processing_pipeline/inst/u_ip/u_core/u_metadata/cam_id_mailbox_reg[2]/Q C=bd_i/processing_pipeline/inst/u_ip/u_core/u_metadata/cam_id_mailbox_reg[2]/C
metadata_sof_identity TIMED_D bd_i/processing_pipeline/inst/u_ip/u_core/u_metadata/id_sync1_reg[30]/D Q=bd_i/processing_pipeline/inst/u_ip/u_core/u_metadata/cam_id_mailbox_reg[30]/Q C=bd_i/processing_pipeline/inst/u_ip/u_core/u_metadata/cam_id_mailbox_reg[30]/C
metadata_sof_identity TIMED_D bd_i/processing_pipeline/inst/u_ip/u_core/u_metadata/id_sync1_reg[31]/D Q=bd_i/processing_pipeline/inst/u_ip/u_core/u_metadata/cam_id_mailbox_reg[31]/Q C=bd_i/processing_pipeline/inst/u_ip/u_core/u_metadata/cam_id_mailbox_reg[31]/C
metadata_sof_identity TIMED_D bd_i/processing_pipeline/inst/u_ip/u_core/u_metadata/id_sync1_reg[3]/D Q=bd_i/processing_pipeline/inst/u_ip/u_core/u_metadata/cam_id_mailbox_reg[3]/Q C=bd_i/processing_pipeline/inst/u_ip/u_core/u_metadata/cam_id_mailbox_reg[3]/C
metadata_sof_identity TIMED_D bd_i/processing_pipeline/inst/u_ip/u_core/u_metadata/id_sync1_reg[4]/D Q=bd_i/processing_pipeline/inst/u_ip/u_core/u_metadata/cam_id_mailbox_reg[4]/Q C=bd_i/processing_pipeline/inst/u_ip/u_core/u_metadata/cam_id_mailbox_reg[4]/C
metadata_sof_identity TIMED_D bd_i/processing_pipeline/inst/u_ip/u_core/u_metadata/id_sync1_reg[5]/D Q=bd_i/processing_pipeline/inst/u_ip/u_core/u_metadata/cam_id_mailbox_reg[5]/Q C=bd_i/processing_pipeline/inst/u_ip/u_core/u_metadata/cam_id_mailbox_reg[5]/C
metadata_sof_identity TIMED_D bd_i/processing_pipeline/inst/u_ip/u_core/u_metadata/id_sync1_reg[6]/D Q=bd_i/processing_pipeline/inst/u_ip/u_core/u_metadata/cam_id_mailbox_reg[6]/Q C=bd_i/processing_pipeline/inst/u_ip/u_core/u_metadata/cam_id_mailbox_reg[6]/C
metadata_sof_identity TIMED_D bd_i/processing_pipeline/inst/u_ip/u_core/u_metadata/id_sync1_reg[7]/D Q=bd_i/processing_pipeline/inst/u_ip/u_core/u_metadata/cam_id_mailbox_reg[7]/Q C=bd_i/processing_pipeline/inst/u_ip/u_core/u_metadata/cam_id_mailbox_reg[7]/C
metadata_sof_identity TIMED_D bd_i/processing_pipeline/inst/u_ip/u_core/u_metadata/id_sync1_reg[8]/D Q=bd_i/processing_pipeline/inst/u_ip/u_core/u_metadata/cam_id_mailbox_reg[8]/Q C=bd_i/processing_pipeline/inst/u_ip/u_core/u_metadata/cam_id_mailbox_reg[8]/C
metadata_sof_identity TIMED_D bd_i/processing_pipeline/inst/u_ip/u_core/u_metadata/id_sync1_reg[9]/D Q=bd_i/processing_pipeline/inst/u_ip/u_core/u_metadata/cam_id_mailbox_reg[9]/Q C=bd_i/processing_pipeline/inst/u_ip/u_core/u_metadata/cam_id_mailbox_reg[9]/C
metadata_sof_identity source_clock=cam_pclk destination_clock=clk_fpga_0  D=48 timed_D=48 source_Q=48  timing_start_C=48 constants=0 local_feedback=0  max_delay_ns=10 bus_skew=10
pclk_gray_first_stage expected_D=32 actual_D=32
  DEST_D bd_i/processing_pipeline/inst/u_ip/u_pclk_meter/gray_sync_1_reg[0]/D
  DEST_D bd_i/processing_pipeline/inst/u_ip/u_pclk_meter/gray_sync_1_reg[10]/D
  DEST_D bd_i/processing_pipeline/inst/u_ip/u_pclk_meter/gray_sync_1_reg[11]/D
  DEST_D bd_i/processing_pipeline/inst/u_ip/u_pclk_meter/gray_sync_1_reg[12]/D
  DEST_D bd_i/processing_pipeline/inst/u_ip/u_pclk_meter/gray_sync_1_reg[13]/D
  DEST_D bd_i/processing_pipeline/inst/u_ip/u_pclk_meter/gray_sync_1_reg[14]/D
  DEST_D bd_i/processing_pipeline/inst/u_ip/u_pclk_meter/gray_sync_1_reg[15]/D
  DEST_D bd_i/processing_pipeline/inst/u_ip/u_pclk_meter/gray_sync_1_reg[16]/D
  DEST_D bd_i/processing_pipeline/inst/u_ip/u_pclk_meter/gray_sync_1_reg[17]/D
  DEST_D bd_i/processing_pipeline/inst/u_ip/u_pclk_meter/gray_sync_1_reg[18]/D
  DEST_D bd_i/processing_pipeline/inst/u_ip/u_pclk_meter/gray_sync_1_reg[19]/D
  DEST_D bd_i/processing_pipeline/inst/u_ip/u_pclk_meter/gray_sync_1_reg[1]/D
  DEST_D bd_i/processing_pipeline/inst/u_ip/u_pclk_meter/gray_sync_1_reg[20]/D
  DEST_D bd_i/processing_pipeline/inst/u_ip/u_pclk_meter/gray_sync_1_reg[21]/D
  DEST_D bd_i/processing_pipeline/inst/u_ip/u_pclk_meter/gray_sync_1_reg[22]/D
  DEST_D bd_i/processing_pipeline/inst/u_ip/u_pclk_meter/gray_sync_1_reg[23]/D
  DEST_D bd_i/processing_pipeline/inst/u_ip/u_pclk_meter/gray_sync_1_reg[24]/D
  DEST_D bd_i/processing_pipeline/inst/u_ip/u_pclk_meter/gray_sync_1_reg[25]/D
  DEST_D bd_i/processing_pipeline/inst/u_ip/u_pclk_meter/gray_sync_1_reg[26]/D
  DEST_D bd_i/processing_pipeline/inst/u_ip/u_pclk_meter/gray_sync_1_reg[27]/D
  DEST_D bd_i/processing_pipeline/inst/u_ip/u_pclk_meter/gray_sync_1_reg[28]/D
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
pclk_gray TIMED_D bd_i/processing_pipeline/inst/u_ip/u_pclk_meter/gray_sync_1_reg[3]/D Q=bd_i/processing_pipeline/inst/u_ip/u_pclk_meter/cam_count_gray_reg[3]/Q C=bd_i/processing_pipeline/inst/u_ip/u_pclk_meter/cam_count_gray_reg[3]/C
pclk_gray TIMED_D bd_i/processing_pipeline/inst/u_ip/u_pclk_meter/gray_sync_1_reg[4]/D Q=bd_i/processing_pipeline/inst/u_ip/u_pclk_meter/cam_count_gray_reg[4]/Q C=bd_i/processing_pipeline/inst/u_ip/u_pclk_meter/cam_count_gray_reg[4]/C
pclk_gray TIMED_D bd_i/processing_pipeline/inst/u_ip/u_pclk_meter/gray_sync_1_reg[5]/D Q=bd_i/processing_pipeline/inst/u_ip/u_pclk_meter/cam_count_gray_reg[5]/Q C=bd_i/processing_pipeline/inst/u_ip/u_pclk_meter/cam_count_gray_reg[5]/C
pclk_gray TIMED_D bd_i/processing_pipeline/inst/u_ip/u_pclk_meter/gray_sync_1_reg[6]/D Q=bd_i/processing_pipeline/inst/u_ip/u_pclk_meter/cam_count_gray_reg[6]/Q C=bd_i/processing_pipeline/inst/u_ip/u_pclk_meter/cam_count_gray_reg[6]/C
pclk_gray TIMED_D bd_i/processing_pipeline/inst/u_ip/u_pclk_meter/gray_sync_1_reg[7]/D Q=bd_i/processing_pipeline/inst/u_ip/u_pclk_meter/cam_count_gray_reg[7]/Q C=bd_i/processing_pipeline/inst/u_ip/u_pclk_meter/cam_count_gray_reg[7]/C
pclk_gray TIMED_D bd_i/processing_pipeline/inst/u_ip/u_pclk_meter/gray_sync_1_reg[8]/D Q=bd_i/processing_pipeline/inst/u_ip/u_pclk_meter/cam_count_gray_reg[8]/Q C=bd_i/processing_pipeline/inst/u_ip/u_pclk_meter/cam_count_gray_reg[8]/C
pclk_gray TIMED_D bd_i/processing_pipeline/inst/u_ip/u_pclk_meter/gray_sync_1_reg[9]/D Q=bd_i/processing_pipeline/inst/u_ip/u_pclk_meter/cam_count_gray_reg[9]/Q C=bd_i/processing_pipeline/inst/u_ip/u_pclk_meter/cam_count_gray_reg[9]/C
pclk_gray source_clock=cam_pclk destination_clock=clk_fpga_0  D=32 timed_D=32 source_Q=32  timing_start_C=32 constants=0 local_feedback=0  max_delay_ns=10 bus_skew=10
monitor_command_toggle_first_stage expected_D=1 actual_D=1
  DEST_D bd_i/processing_pipeline/inst/u_ip/u_signal_monitor/cmd_sync1_reg/D
monitor_command_toggle TIMED_D bd_i/processing_pipeline/inst/u_ip/u_signal_monitor/cmd_sync1_reg/D Q=bd_i/processing_pipeline/inst/u_ip/u_signal_monitor/cmd_toggle_reg/Q C=bd_i/processing_pipeline/inst/u_ip/u_signal_monitor/cmd_toggle_reg/C
monitor_command_toggle source_clock=clk_fpga_0 destination_clock=cam_pclk  D=1 timed_D=1 source_Q=1  timing_start_C=1 constants=0 local_feedback=0  max_delay_ns=10 bus_skew=0
monitor_ack_toggle_first_stage expected_D=1 actual_D=1
  DEST_D bd_i/processing_pipeline/inst/u_ip/u_signal_monitor/cmd_ack_sync1_reg/D
monitor_ack_toggle TIMED_D bd_i/processing_pipeline/inst/u_ip/u_signal_monitor/cmd_ack_sync1_reg/D Q=bd_i/processing_pipeline/inst/u_ip/u_signal_monitor/cmd_ack_toggle_cam_reg/Q C=bd_i/processing_pipeline/inst/u_ip/u_signal_monitor/cmd_ack_toggle_cam_reg/C
monitor_ack_toggle source_clock=cam_pclk destination_clock=clk_fpga_0  D=1 timed_D=1 source_Q=1  timing_start_C=1 constants=0 local_feedback=0  max_delay_ns=10 bus_skew=0
monitor_done_toggle_first_stage expected_D=1 actual_D=1
  DEST_D bd_i/processing_pipeline/inst/u_ip/u_signal_monitor/done_sync1_reg/D
monitor_done_toggle TIMED_D bd_i/processing_pipeline/inst/u_ip/u_signal_monitor/done_sync1_reg/D Q=bd_i/processing_pipeline/inst/u_ip/u_signal_monitor/done_toggle_cam_reg/Q C=bd_i/processing_pipeline/inst/u_ip/u_signal_monitor/done_toggle_cam_reg/C
monitor_done_toggle source_clock=cam_pclk destination_clock=clk_fpga_0  D=1 timed_D=1 source_Q=1  timing_start_C=1 constants=0 local_feedback=0  max_delay_ns=10 bus_skew=0
monitor_command_payload_capture expected_D=33 actual_D=33
  DEST_D bd_i/processing_pipeline/inst/u_ip/u_signal_monitor/cmd_result_id_stage_cam_reg[0]/D
  DEST_D bd_i/processing_pipeline/inst/u_ip/u_signal_monitor/cmd_result_id_stage_cam_reg[10]/D
  DEST_D bd_i/processing_pipeline/inst/u_ip/u_signal_monitor/cmd_result_id_stage_cam_reg[11]/D
  DEST_D bd_i/processing_pipeline/inst/u_ip/u_signal_monitor/cmd_result_id_stage_cam_reg[12]/D
  DEST_D bd_i/processing_pipeline/inst/u_ip/u_signal_monitor/cmd_result_id_stage_cam_reg[13]/D
  DEST_D bd_i/processing_pipeline/inst/u_ip/u_signal_monitor/cmd_result_id_stage_cam_reg[14]/D
  DEST_D bd_i/processing_pipeline/inst/u_ip/u_signal_monitor/cmd_result_id_stage_cam_reg[15]/D
  DEST_D bd_i/processing_pipeline/inst/u_ip/u_signal_monitor/cmd_result_id_stage_cam_reg[16]/D
  DEST_D bd_i/processing_pipeline/inst/u_ip/u_signal_monitor/cmd_result_id_stage_cam_reg[17]/D
  DEST_D bd_i/processing_pipeline/inst/u_ip/u_signal_monitor/cmd_result_id_stage_cam_reg[18]/D
  DEST_D bd_i/processing_pipeline/inst/u_ip/u_signal_monitor/cmd_result_id_stage_cam_reg[19]/D
  DEST_D bd_i/processing_pipeline/inst/u_ip/u_signal_monitor/cmd_result_id_stage_cam_reg[1]/D
  DEST_D bd_i/processing_pipeline/inst/u_ip/u_signal_monitor/cmd_result_id_stage_cam_reg[20]/D
  DEST_D bd_i/processing_pipeline/inst/u_ip/u_signal_monitor/cmd_result_id_stage_cam_reg[21]/D
  DEST_D bd_i/processing_pipeline/inst/u_ip/u_signal_monitor/cmd_result_id_stage_cam_reg[22]/D
  DEST_D bd_i/processing_pipeline/inst/u_ip/u_signal_monitor/cmd_result_id_stage_cam_reg[23]/D
  DEST_D bd_i/processing_pipeline/inst/u_ip/u_signal_monitor/cmd_result_id_stage_cam_reg[24]/D
  DEST_D bd_i/processing_pipeline/inst/u_ip/u_signal_monitor/cmd_result_id_stage_cam_reg[25]/D
  DEST_D bd_i/processing_pipeline/inst/u_ip/u_signal_monitor/cmd_result_id_stage_cam_reg[26]/D
  DEST_D bd_i/processing_pipeline/inst/u_ip/u_signal_monitor/cmd_result_id_stage_cam_reg[27]/D
  DEST_D bd_i/processing_pipeline/inst/u_ip/u_signal_monitor/cmd_result_id_stage_cam_reg[28]/D
  DEST_D bd_i/processing_pipeline/inst/u_ip/u_signal_monitor/cmd_result_id_stage_cam_reg[29]/D
  DEST_D bd_i/processing_pipeline/inst/u_ip/u_signal_monitor/cmd_result_id_stage_cam_reg[2]/D
  DEST_D bd_i/processing_pipeline/inst/u_ip/u_signal_monitor/cmd_result_id_stage_cam_reg[30]/D
  DEST_D bd_i/processing_pipeline/inst/u_ip/u_signal_monitor/cmd_result_id_stage_cam_reg[31]/D
  DEST_D bd_i/processing_pipeline/inst/u_ip/u_signal_monitor/cmd_result_id_stage_cam_reg[3]/D
  DEST_D bd_i/processing_pipeline/inst/u_ip/u_signal_monitor/cmd_result_id_stage_cam_reg[4]/D
  DEST_D bd_i/processing_pipeline/inst/u_ip/u_signal_monitor/cmd_result_id_stage_cam_reg[5]/D
  DEST_D bd_i/processing_pipeline/inst/u_ip/u_signal_monitor/cmd_result_id_stage_cam_reg[6]/D
  DEST_D bd_i/processing_pipeline/inst/u_ip/u_signal_monitor/cmd_result_id_stage_cam_reg[7]/D
  DEST_D bd_i/processing_pipeline/inst/u_ip/u_signal_monitor/cmd_result_id_stage_cam_reg[8]/D
  DEST_D bd_i/processing_pipeline/inst/u_ip/u_signal_monitor/cmd_result_id_stage_cam_reg[9]/D
  DEST_D bd_i/processing_pipeline/inst/u_ip/u_signal_monitor/cmd_start_stage_cam_reg/D
monitor_command_payload TIMED_D bd_i/processing_pipeline/inst/u_ip/u_signal_monitor/cmd_result_id_stage_cam_reg[0]/D Q=bd_i/processing_pipeline/inst/u_ip/u_signal_monitor/cmd_result_id_reg[0]/Q C=bd_i/processing_pipeline/inst/u_ip/u_signal_monitor/cmd_result_id_reg[0]/C
monitor_command_payload TIMED_D bd_i/processing_pipeline/inst/u_ip/u_signal_monitor/cmd_result_id_stage_cam_reg[10]/D Q=bd_i/processing_pipeline/inst/u_ip/u_signal_monitor/cmd_result_id_reg[10]/Q C=bd_i/processing_pipeline/inst/u_ip/u_signal_monitor/cmd_result_id_reg[10]/C
monitor_command_payload TIMED_D bd_i/processing_pipeline/inst/u_ip/u_signal_monitor/cmd_result_id_stage_cam_reg[11]/D Q=bd_i/processing_pipeline/inst/u_ip/u_signal_monitor/cmd_result_id_reg[11]/Q C=bd_i/processing_pipeline/inst/u_ip/u_signal_monitor/cmd_result_id_reg[11]/C
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
monitor_command_payload TIMED_D bd_i/processing_pipeline/inst/u_ip/u_signal_monitor/cmd_result_id_stage_cam_reg[6]/D Q=bd_i/processing_pipeline/inst/u_ip/u_signal_monitor/cmd_result_id_reg[6]/Q C=bd_i/processing_pipeline/inst/u_ip/u_signal_monitor/cmd_result_id_reg[6]/C
monitor_command_payload TIMED_D bd_i/processing_pipeline/inst/u_ip/u_signal_monitor/cmd_result_id_stage_cam_reg[7]/D Q=bd_i/processing_pipeline/inst/u_ip/u_signal_monitor/cmd_result_id_reg[7]/Q C=bd_i/processing_pipeline/inst/u_ip/u_signal_monitor/cmd_result_id_reg[7]/C
monitor_command_payload TIMED_D bd_i/processing_pipeline/inst/u_ip/u_signal_monitor/cmd_result_id_stage_cam_reg[8]/D Q=bd_i/processing_pipeline/inst/u_ip/u_signal_monitor/cmd_result_id_reg[8]/Q C=bd_i/processing_pipeline/inst/u_ip/u_signal_monitor/cmd_result_id_reg[8]/C
monitor_command_payload TIMED_D bd_i/processing_pipeline/inst/u_ip/u_signal_monitor/cmd_result_id_stage_cam_reg[9]/D Q=bd_i/processing_pipeline/inst/u_ip/u_signal_monitor/cmd_result_id_reg[9]/Q C=bd_i/processing_pipeline/inst/u_ip/u_signal_monitor/cmd_result_id_reg[9]/C
monitor_command_payload TIMED_D bd_i/processing_pipeline/inst/u_ip/u_signal_monitor/cmd_start_stage_cam_reg/D Q=bd_i/processing_pipeline/inst/u_ip/u_signal_monitor/cmd_is_start_reg/Q C=bd_i/processing_pipeline/inst/u_ip/u_signal_monitor/cmd_is_start_reg/C
monitor_command_payload source_clock=clk_fpga_0 destination_clock=cam_pclk  D=33 timed_D=33 source_Q=33  timing_start_C=33 constants=0 local_feedback=0  max_delay_ns=10 bus_skew=10
monitor_result_payload_capture expected_D=501 actual_D=501
  DEST_D bd_i/processing_pipeline/inst/u_ip/u_signal_monitor/done_error_flags_stage_sys_reg[0]/D
  DEST_D bd_i/processing_pipeline/inst/u_ip/u_signal_monitor/done_error_flags_stage_sys_reg[1]/D
  DEST_D bd_i/processing_pipeline/inst/u_ip/u_signal_monitor/done_error_flags_stage_sys_reg[2]/D
  DEST_D bd_i/processing_pipeline/inst/u_ip/u_signal_monitor/done_error_flags_stage_sys_reg[3]/D
  DEST_D bd_i/processing_pipeline/inst/u_ip/u_signal_monitor/done_fv_falls_stage_sys_reg[0]/D
  DEST_D bd_i/processing_pipeline/inst/u_ip/u_signal_monitor/done_fv_falls_stage_sys_reg[10]/D
  DEST_D bd_i/processing_pipeline/inst/u_ip/u_signal_monitor/done_fv_falls_stage_sys_reg[11]/D
  DEST_D bd_i/processing_pipeline/inst/u_ip/u_signal_monitor/done_fv_falls_stage_sys_reg[12]/D
  DEST_D bd_i/processing_pipeline/inst/u_ip/u_signal_monitor/done_fv_falls_stage_sys_reg[13]/D
  DEST_D bd_i/processing_pipeline/inst/u_ip/u_signal_monitor/done_fv_falls_stage_sys_reg[14]/D
  DEST_D bd_i/processing_pipeline/inst/u_ip/u_signal_monitor/done_fv_falls_stage_sys_reg[15]/D
  DEST_D bd_i/processing_pipeline/inst/u_ip/u_signal_monitor/done_fv_falls_stage_sys_reg[16]/D
  DEST_D bd_i/processing_pipeline/inst/u_ip/u_signal_monitor/done_fv_falls_stage_sys_reg[17]/D
  DEST_D bd_i/processing_pipeline/inst/u_ip/u_signal_monitor/done_fv_falls_stage_sys_reg[18]/D
  DEST_D bd_i/processing_pipeline/inst/u_ip/u_signal_monitor/done_fv_falls_stage_sys_reg[19]/D
  DEST_D bd_i/processing_pipeline/inst/u_ip/u_signal_monitor/done_fv_falls_stage_sys_reg[1]/D
  DEST_D bd_i/processing_pipeline/inst/u_ip/u_signal_monitor/done_fv_falls_stage_sys_reg[20]/D
  DEST_D bd_i/processing_pipeline/inst/u_ip/u_signal_monitor/done_fv_falls_stage_sys_reg[21]/D
  DEST_D bd_i/processing_pipeline/inst/u_ip/u_signal_monitor/done_fv_falls_stage_sys_reg[22]/D
  DEST_D bd_i/processing_pipeline/inst/u_ip/u_signal_monitor/done_fv_falls_stage_sys_reg[23]/D
  DEST_D bd_i/processing_pipeline/inst/u_ip/u_signal_monitor/done_fv_falls_stage_sys_reg[24]/D
  DEST_D bd_i/processing_pipeline/inst/u_ip/u_signal_monitor/done_fv_falls_stage_sys_reg[25]/D
  DEST_D bd_i/processing_pipeline/inst/u_ip/u_signal_monitor/done_fv_falls_stage_sys_reg[26]/D
  DEST_D bd_i/processing_pipeline/inst/u_ip/u_signal_monitor/done_fv_falls_stage_sys_reg[27]/D
  DEST_D bd_i/processing_pipeline/inst/u_ip/u_signal_monitor/done_fv_falls_stage_sys_reg[28]/D
  DEST_D bd_i/processing_pipeline/inst/u_ip/u_signal_monitor/done_fv_falls_stage_sys_reg[29]/D
  DEST_D bd_i/processing_pipeline/inst/u_ip/u_signal_monitor/done_fv_falls_stage_sys_reg[2]/D
  DEST_D bd_i/processing_pipeline/inst/u_ip/u_signal_monitor/done_fv_falls_stage_sys_reg[30]/D
  DEST_D bd_i/processing_pipeline/inst/u_ip/u_signal_monitor/done_fv_falls_stage_sys_reg[31]/D
  DEST_D bd_i/processing_pipeline/inst/u_ip/u_signal_monitor/done_fv_falls_stage_sys_reg[3]/D
  DEST_D bd_i/processing_pipeline/inst/u_ip/u_signal_monitor/done_fv_falls_stage_sys_reg[4]/D
  DEST_D bd_i/processing_pipeline/inst/u_ip/u_signal_monitor/done_fv_falls_stage_sys_reg[5]/D
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
  DEST_D bd_i/processing_pipeline/inst/u_ip/u_signal_monitor/done_rows_max_stage_sys_reg[31]/D
  DEST_D bd_i/processing_pipeline/inst/u_ip/u_signal_monitor/done_rows_max_stage_sys_reg[3]/D
  DEST_D bd_i/processing_pipeline/inst/u_ip/u_signal_monitor/done_rows_max_stage_sys_reg[4]/D
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
