ForrestKang/fpga-line-laser-3d-measurement/board/historical_outputs/scan_models_20261031/vase_scan.stl

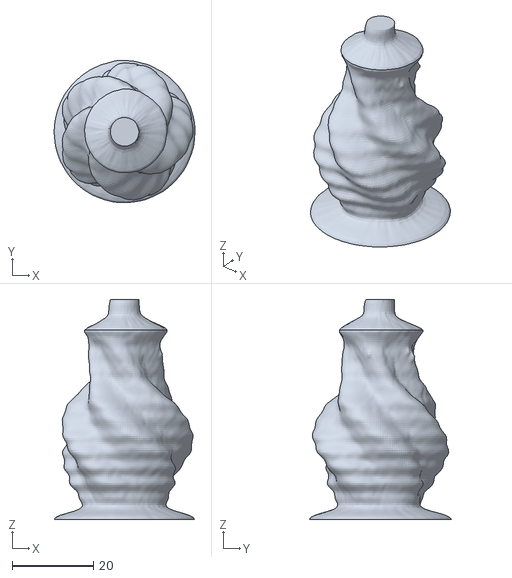
[picture p45: CAD file, 2026-11-02]
board/historical_outputs/scan_models_20261031/vase_scan.stl
34.5 x 34.9 x 54.0
