ForrestKang/fpga-line-laser-3d-measurement/board/historical_outputs/scan_models_20261031/t02_scan.stl

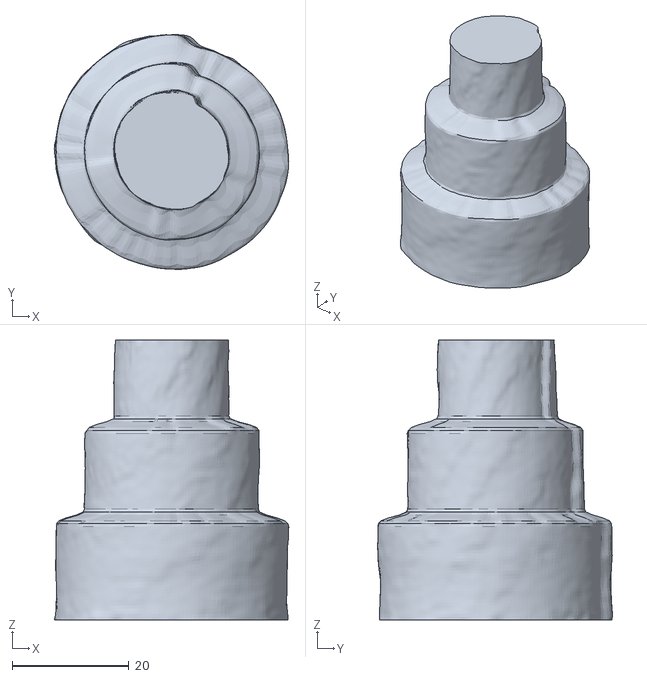
[picture p46: CAD file, 2026-11-02]
board/historical_outputs/scan_models_20261031/t02_scan.stl
40.2 x 40.2 x 48.0
