ForrestKang/fpga-line-laser-3d-measurement/report/calibration_photos/step_capture.png

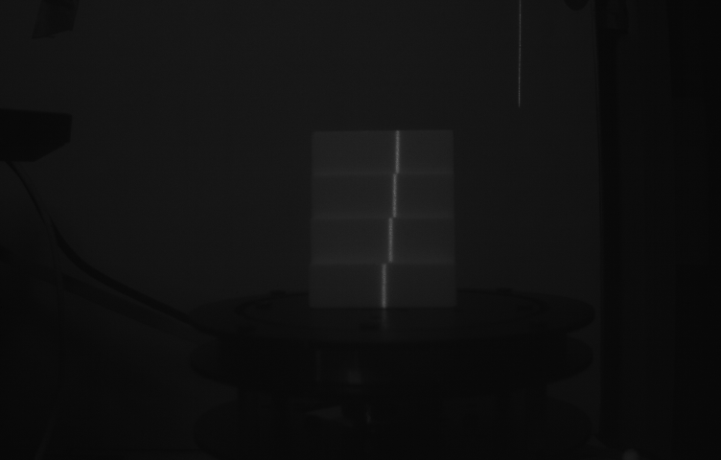
report/calibration_photos/step_capture.png
