ForrestKang/fpga-line-laser-3d-measurement/data/calibration/validation/t01_camera_frame.jpg

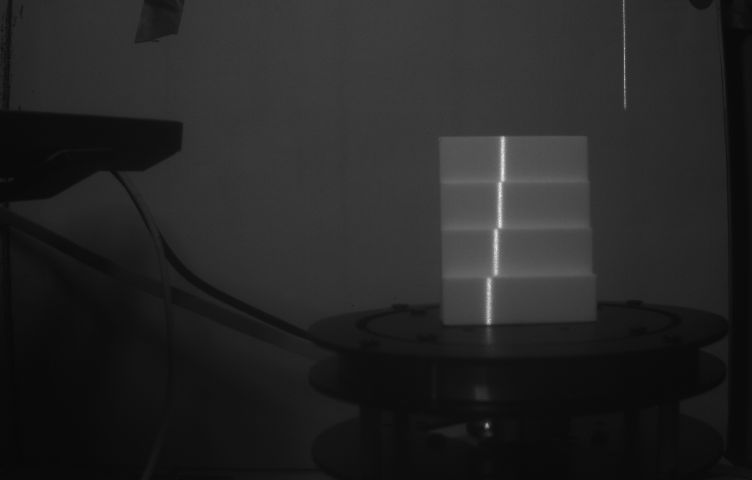
data/calibration/validation/t01_camera_frame.jpg
