ForrestKang/fpga-line-laser-3d-measurement/report/calibration_photos/checkerboard_pairs.png

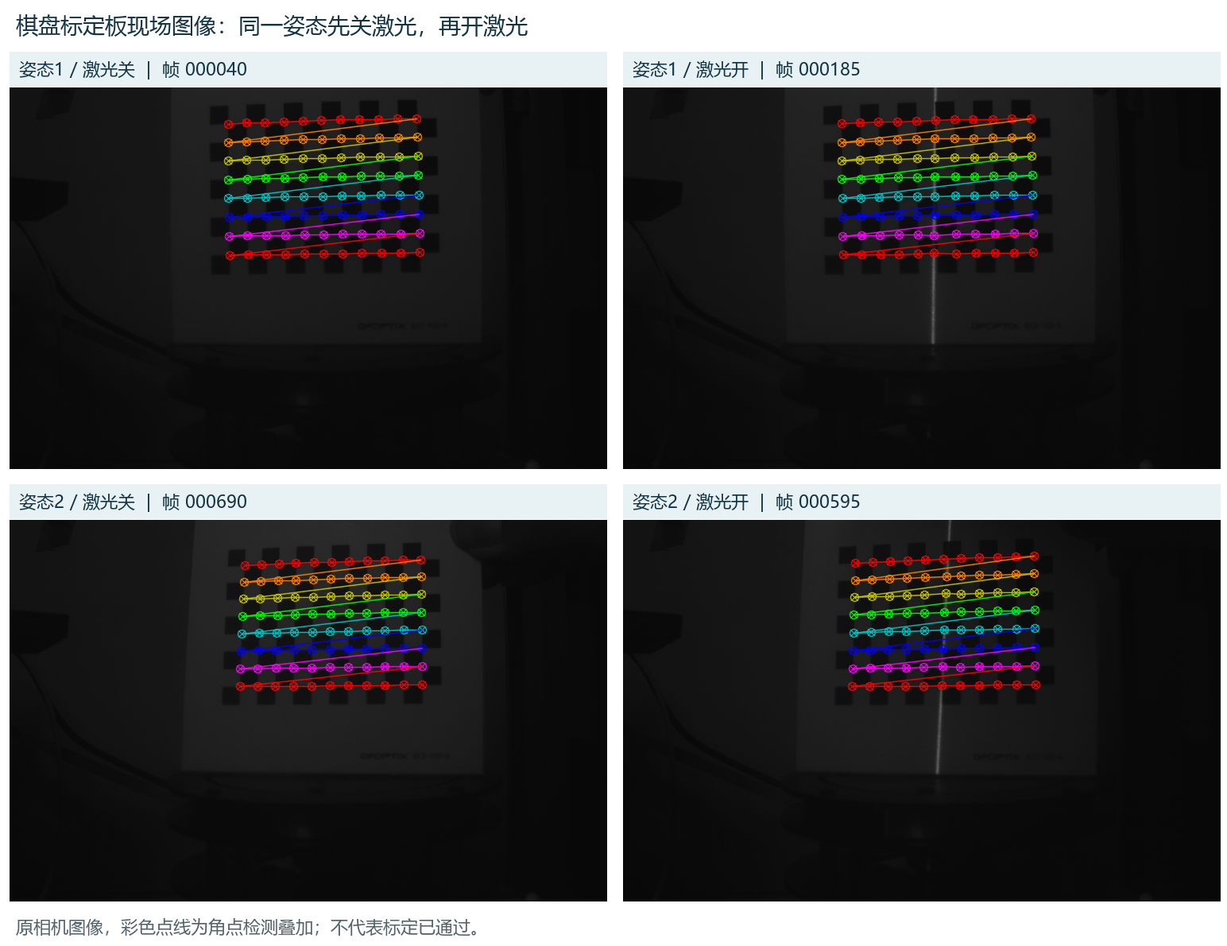
report/calibration_photos/checkerboard_pairs.png
