ForrestKang/fpga-line-laser-3d-measurement/src/fpga/constraints/board_buttons.xdc

# R42 buttons: verified against Xilinx/PYNQ official logictools XDC.
set_property -dict {PACKAGE_PIN D19 IOSTANDARD LVCMOS33} [get_ports {btn[0]}]
set_property -dict {PACKAGE_PIN D20 IOSTANDARD LVCMOS33} [get_ports {btn[1]}]
set_property -dict {PACKAGE_PIN L20 IOSTANDARD LVCMOS33} [get_ports {btn[2]}]
set_property -dict {PACKAGE_PIN L19 IOSTANDARD LVCMOS33} [get_ports {btn[3]}]
