ForrestKang/fpga-line-laser-3d-measurement/src/fpga/rtl/pixel_frontend.sv

`timescale 1ns/1ps
// parallel production builds may select direction lanes without changing AXI/BD ports.
`ifndef DIRECTION_LANES
`define DIRECTION_LANES 2
`endif
`ifndef DIRECTION_DISPATCH
`define DIRECTION_DISPATCH 0
`endif
`ifndef BANKED_DIRECTION_REQUESTS
`define BANKED_DIRECTION_REQUESTS 0
`endif
// Fully bounded framed pixel frontend. The graph is computed in PL from compact
// row-qualified descriptors; the host never links candidates or scans pixels.
`ifndef BANKED_DIRECTION_RESULTS
`define BANKED_DIRECTION_RESULTS 0
`endif
`ifndef BALANCED_DIRECTION_DISPATCH
`define BALANCED_DIRECTION_DISPATCH 0
`endif
module pixel_frontend #(parameter FRAME_WIDTH=752,FRAME_HEIGHT=480,SPARSE_GRAPH=1,ROW_PREFETCH=1,ROW_LANES=`DIRECTION_LANES,ROW_DISPATCH=`DIRECTION_DISPATCH,ROW_BANKED_REQUESTS=`BANKED_DIRECTION_REQUESTS,ROW_BANKED_RESULTS=`BANKED_DIRECTION_RESULTS,ROW_BALANCED_DISPATCH=`BALANCED_DIRECTION_DISPATCH)(
    input wire clk, rst,
    input wire start, abort,
    input wire bin_mode,
    input wire seed_retry_mode,
    input wire [7:0] pixel_data,
    input wire pixel_valid, pixel_sof, pixel_eof,
    output wire pixel_ready,
    output wire [511:0] record_data,
    output wire [1:0] record_kind,
    output wire record_valid,
    input wire record_ready,
    output reg busy, done, error,
    output reg [31:0] error_code,
    output reg [31:0] diagnostic_count, qualified_count,
    output reg [31:0] measurement_count, preview_count,
    output reg [31:0] measurement_rows, preview_rows, ambiguous_count,
    output reg [31:0] sat250_count, sat255_count,
    output reg [31:0] flags,
    output reg [31:0] measure_status, preview_status,
    output reg [31:0] measure_median_peak_x2,measure_median_width_x2,
    output reg [31:0] preview_median_peak_x2,preview_median_width_x2,
    output reg [31:0] raw_peak_median_x2,
    output reg frame_measurement_usable,frame_preview_usable,
    output reg [31:0] frame_quality_flags,ambiguous_rows,
    output reg [63:0] processing_cycles,
    output reg [31:0] input_bytes,
    output wire geometry_valid,input wire geometry_ready,
    output wire [31:0] geometry_u_q12,geometry_v_q12,geometry_candidate_id,
    output wire [1:0] geometry_modes

);
 localparam N=FRAME_HEIGHT*16;
 localparam IDLE=0,INGRESS=1,INIT=2,PAIR_ADDR=3,PAIR_WAIT=4,PAIR_APPLY=5,
 LABEL_ADDR=6,LABEL_WAIT=7,LABEL_PRED=8,LABEL_PWAIT=9,LABEL_ROOT=10,
 LABEL_RWAIT=11,LABEL_WRITE=12,OUT_ADDR=13,OUT_WAIT=14,OUT_ROOT=15,
 OUT_RWAIT=16,OUT_BUILD=17,OUT_SEND=18,ROW_SEND=19,HIST=20,FINISH=21,PAIR_LATCH=22,HIST_READ=23,PAIR_REDUCE0=24,PAIR_REDUCE1=25,PAIR_COMPARE=26,G_ADDR=27,G_WAIT=28,G_SEND=29,OUT_QUALIFY=30;
 reg [5:0] state;
 reg clear_row;
 reg geometry_captured;
 wire row_ready,row_done,row_slot_we,row_we,local_overflow,border_seen;
 wire [511:0] local_diag;
 wire local_valid;
 wire [12:0] row_slot_addr;
 wire [95:0] row_slot_data;
 wire [8:0] row_index;
 wire [191:0] row_data;
 wire [31:0] local_raw,local_qualified,local_sat250,local_sat255;
 wire [383:0] desc_b4;
 (* ram_style="distributed" *) reg [191:0] rows[0:FRAME_HEIGHT-1];
 reg [12:0] addr_a,addr_b,node,root_id;
 wire [95:0] da,db;
 reg [95:0] held_desc;
 wire [4:0] pca,pcb,sca,scb;
 wire [12:0] pra,prb,la,lb;
 wire [8:0] sua,sub;
 wire ama,amb;
 wire [14:0] sta,stb;
 reg [1:0] pass;
 reg [8:0] pair_y,out_y;
 // b09: {overflow, count} of rows[pair_y-1] (rp) and rows[pair_y] (rc), updated on the same
 // edge as pair_y, so the pairing branches no longer read the row LUTRAM combinationally.
 reg [5:0] rp,rc;
 reg [3:0] pair_a,pair_b,out_slot;
 reg [511:0] out_record,row_record;
 reg [1:0] out_kind;
 reg [31:0] row_m,row_p,row_mw,row_pw,row_mp,row_pp;
 reg row_amb;
 reg [31:0] slotted_count;
 reg [12:0] hp_m[0:255],hp_p[0:255],hw_m[0:255],hw_p[0:255],hp_raw[0:255];
 reg [8:0] hist_i;
 // b07: the row histogram bin and its incremented count are registered while the row is
 // output (hp_raw is written only in ROW_SEND), so ROW_SEND writes a ready value.
 reg [7:0] hp_key;
 reg [12:0] hp_next;
 reg [31:0] cm,cp,wm,wp,cr;
 reg [12:0] hm,hp,whm,whp,hr;
 reg [7:0] mplo,mphi,pplo,pphi,mwlo,mwhi,pwlo,pwhi,rlo,rhi;
 reg [31:0] amb_rows;
 reg low_support_seen;
 reg [31:0] delta_c,delta_w;
 reg edge_ok,eligible_a,eligible_b,eligible_node;
 reg output_eligible_node; // Frozen per node in OUT_ADDR; label traversal keeps live eligibility.
 reg output_row_overflow; // reference: this node's row exceeded 16 candidates, frozen with eligibility.
 reg edge_reg;
 reg [14:0] edge_delta;
 // Acceptance is captured only after the synchronous root-support read settles.
 // OUT_BUILD consumes this node-owned decision; histogram writes no longer have
 // the root-support RAM comparator in their data/enable path.
 reg can_p,can_m;
 reg [7:0] reason_m,reason_p;
 reg next_can_p,next_can_m;
 reg [7:0] next_reason_m,next_reason_p;
 reg [12:0] canonical;
 integer k;
 wire final_desc_we=state==OUT_BUILD;
 wire [95:0] final_desc={held_desc[95:93],can_p,can_m,held_desc[90:0]};
 assign geometry_valid=state==G_SEND&&geometry_captured&&geometry_modes!=0&&!abort;
 assign geometry_modes={frame_preview_usable&&held_desc[92],frame_measurement_usable&&held_desc[91]};
 reg bin,pair_phase;          // live measurement: binning mode latched at start, pair position
 reg seed_retry_active;      // policy 3: explicit algorithm version, full width only
 reg [7:0] pair_first;
 // live measurement binning: binned centre -> W coordinates, same 23-bit mapping as the wire record.
 wire [22:0] desc_u_full={held_desc[39:18],1'b0}+23'd2048;
 assign geometry_u_q12=bin?{9'b0,desc_u_full}:{10'b0,held_desc[39:18]};
 assign geometry_v_q12=$signed({11'b0,node[12:4],12'b0})+$signed(held_desc[90:78]);
 assign geometry_candidate_id={14'b0,held_desc[17:0]};
 wire init_mem=state==INIT&&node<N;
 wire [12:0] ma=init_mem?node:addr_a;
 // V9 four-lane adjacency: source A is shared, target B slot low bits
 // select four independent banks. A-side updates are reduced before writing.
 reg [3:0] edge4,edge4_reg,bad4_condition,stability_wb;
 reg [14:0] delta4[0:3],delta4_reg[0:3];
 reg [14:0] stability_max;
 reg [19:0] pc_write4;
 reg [59:0] stability_write4;
 reg [31:0] lane_delta_c,lane_delta_w;
 integer lane;
 reg [14:0] stability_max01,stability_max23,stability_max_all;
 reg [3:0] stability_wb_reg;
 reg [21:0] pair_center_a;
 reg [87:0] pair_center_b4;
 reg [9:0] pair_width_a;
 reg [39:0] pair_width_b4;
 reg [3:0] pair_eligible4;
 wire pair_mode=state==PAIR_ADDR||state==PAIR_WAIT||state==PAIR_LATCH||state==PAIR_COMPARE||state==PAIR_REDUCE0||state==PAIR_REDUCE1||state==PAIR_APPLY;
 wire [19:0] pc_b4;
 wire [51:0] pred_b4_unused;
 wire [3:0] amb_b4;
 wire [59:0] stability_b4;
 wire [3:0] edge_apply=(state==PAIR_APPLY)?edge4_reg:4'b0;
 wire [3:0] count4=pass==0?edge_apply:4'b0;
 wire [3:0] bad4=pass==1?edge_apply & bad4_condition:4'b0;
 wire [3:0] stable_pending=pass==2?edge4_reg & ~amb_b4 & {4{!ama}}:4'b0;
 wire [14:0] stable_d0=stable_pending[0]?delta4_reg[0]:15'b0;
 wire [14:0] stable_d1=stable_pending[1]?delta4_reg[1]:15'b0;
 wire [14:0] stable_d2=stable_pending[2]?delta4_reg[2]:15'b0;
 wire [14:0] stable_d3=stable_pending[3]?delta4_reg[3]:15'b0;
 wire [4:0] count_sum={4'b0,count4[0]}+{4'b0,count4[1]}+{4'b0,count4[2]}+{4'b0,count4[3]};
 always @*begin
  edge4=0;bad4_condition=0;stability_max=0;stability_wb=0;
  pc_write4=0;stability_write4=0;lane_delta_c=0;lane_delta_w=0;
  for(lane=0;lane<4;lane=lane+1)begin
   lane_delta_c=(pair_center_a>pair_center_b4[lane*22+:22])?
     pair_center_a-pair_center_b4[lane*22+:22]:pair_center_b4[lane*22+:22]-pair_center_a;
   lane_delta_w=(pair_width_a>pair_width_b4[lane*10+:10])?
     pair_width_a-pair_width_b4[lane*10+:10]:pair_width_b4[lane*10+:10]-pair_width_a;
   edge4[lane]=pair_eligible4[lane]&&
      lane_delta_c<=24576&&lane_delta_w<=8;
   delta4[lane]=lane_delta_c[14:0];
   bad4_condition[lane]=sca!=1||pc_b4[lane*5+:5]!=1;
   pc_write4[lane*5+:5]=pc_b4[lane*5+:5]+5'd1;
   stability_write4[lane*15+:15]=delta4_reg[lane];
   stability_wb[lane]=stable_pending[lane]&&delta4_reg[lane]>stability_b4[lane*15+:15];
  end
 end
 pfo3_banked_ram #(.WIDTH(96),.DEPTH(N)) desc_ram(
  clk,row_slot_we?row_slot_addr:addr_a,addr_b,row_slot_we||final_desc_we,row_slot_we?row_slot_data:final_desc,
  pair_mode,4'b0,384'b0,da,db,desc_b4);
 pfo3_banked_ram #(.WIDTH(5),.DEPTH(N)) pc_ram(
  clk,ma,addr_b,init_mem,5'b0,pair_mode,count4,pc_write4,pca,pcb,pc_b4);
 pfo3_tdp_ram #(.WIDTH(5),.DEPTH(N)) sc_ram(
  clk,ma,addr_b,init_mem||(|count4),1'b0,init_mem?5'b0:sca+count_sum,5'b0,sca,scb);
 pfo3_banked_ram #(.WIDTH(13),.DEPTH(N)) pred_ram(
  clk,ma,addr_b,init_mem,13'b0,pair_mode,count4,{4{addr_a}},pra,prb,pred_b4_unused);
 pfo3_tdp_ram #(.WIDTH(13),.DEPTH(N)) label_ram(clk,ma,addr_b,init_mem||state==LABEL_WRITE,1'b0,init_mem?13'h1fff:root_id,13'b0,la,lb);
 pfo3_tdp_ram #(.WIDTH(9),.DEPTH(N)) support_ram(clk,ma,addr_b,init_mem,state==LABEL_WRITE,9'b0,sub+9'd1,sua,sub);
 pfo3_banked_ram #(.WIDTH(1),.DEPTH(N)) amb_ram(
  clk,ma,addr_b,init_mem||(|bad4),!init_mem,pair_mode,bad4,4'b1111,ama,amb,amb_b4);
 pfo3_banked_ram #(.WIDTH(15),.DEPTH(N)) stability_ram(
  clk,ma,addr_b,init_mem||(state==PAIR_APPLY&&pass==2&&stability_max_all>sta),init_mem?15'b0:stability_max_all,
  pair_mode,(state==PAIR_APPLY&&pass==2)?stability_wb_reg:4'b0,stability_write4,sta,stb,stability_b4);
 // live measurement 2x horizontal binning (bin latched at start): the first pixel of a pair is held, the
 // row engine gets the rounded pair mean with the second one. Input accounting is unchanged.
 wire [8:0] pair_sum={1'b0,pair_first}+{1'b0,pixel_data}+9'd1;
 stripe_extractor #(.W(FRAME_WIDTH),.H(FRAME_HEIGHT),.PREFETCH(ROW_PREFETCH),.LANES(ROW_LANES),.DISPATCH(ROW_DISPATCH),.BANKED_REQUESTS(ROW_BANKED_REQUESTS),.BANKED_RESULTS(ROW_BANKED_RESULTS),.BALANCED_DISPATCH(ROW_BALANCED_DISPATCH)) row_engine(
  .clk(clk),.rst(rst),.clear(clear_row),.bin(bin),.seed_retry_enable(seed_retry_active),.pixel_data(bin?pair_sum[8:1]:pixel_data),
  .pixel_valid(pixel_valid&&busy&&state==INGRESS&&!clear_row&&(!bin||pair_phase)),.pixel_ready(row_ready),
  .diag_data(local_diag),.diag_valid(local_valid),.diag_ready(record_ready&&state==INGRESS),
  .slot_we(row_slot_we),.slot_addr(row_slot_addr),.slot_data(row_slot_data),
  .row_we(row_we),.row_addr(row_index),.row_data(row_data),.finished(row_done),
  .raw_count(local_raw),.qualified_count(local_qualified),.sat250_count(local_sat250),
  .sat255_count(local_sat255),.overflow(local_overflow),.border_seen(border_seen));
 assign pixel_ready=busy&&state==INGRESS&&row_ready&&!abort&&!clear_row;
 assign record_data=state==INGRESS?local_diag:out_record;
 assign record_kind=state==INGRESS?2'd0:out_kind;
 assign record_valid=!abort&&!clear_row&&busy&&((state==INGRESS&&local_valid)||state==OUT_SEND||state==ROW_SEND);
 always @(posedge clk)begin
  if(row_we)rows[row_index]<=row_data;
 end
 // Row metadata kept beside rows (same writes) so rows keeps its b09 read ports: extra
 // reads of rows itself (constant or pair_y+1 addresses) turn the whole table into FFs.
 (* ram_style="distributed" *) reg [5:0] rmeta_mem[0:FRAME_HEIGHT-1];
 reg [5:0] rmeta0,rmeta1;
 always @(posedge clk)begin
  if(row_we)begin
   rmeta_mem[row_index]<={row_data[8],row_data[4:0]};
   if(row_index==0)rmeta0<={row_data[8],row_data[4:0]};
   if(row_index==1)rmeta1<={row_data[8],row_data[4:0]};
  end
 end
 wire [5:0] rmeta_next=rmeta_mem[pair_y+1];
 always @*begin
  delta_c=(da[39:18]>db[39:18])?da[39:18]-db[39:18]:db[39:18]-da[39:18];
  delta_w=(da[49:40]>db[49:40])?da[49:40]-db[49:40]:db[49:40]-da[49:40];
  eligible_a=pair_a<rp[4:0]&&!rp[5];
  eligible_b=pair_b<rc[4:0]&&!rc[5];
  edge_ok=eligible_a&&eligible_b&&delta_c<=24576&&delta_w<=8;
  eligible_node=(node[3:0]<rows[node>>4][4:0])&&!rows[node>>4][8];
  next_can_p=output_eligible_node&&!ama&&sub>=3; // reference: overflow rows are already ineligible
  next_can_m=next_can_p&&sub>=8&&held_desc[69:50]>=73728;
  next_reason_p=0;next_reason_m=0;
  if(output_row_overflow)begin next_reason_p=6;next_reason_m=6;end
  else if(ama)begin next_reason_p=2;next_reason_m=2;end
  else begin
   if(sub<3)next_reason_p=3;
   if(sub<8)next_reason_m=3;else if(held_desc[69:50]<73728)next_reason_m=5;
  end
  canonical=(la==13'h1fff)?13'h1fff:la;
 end
 always @(posedge clk)begin
  clear_row<=0;done<=0;
  if(rst)begin
   state<=IDLE;can_p<=0;can_m<=0;reason_p<=0;reason_m<=0;output_eligible_node<=0;output_row_overflow<=0;geometry_captured<=0;busy<=0;done<=0;error<=0;error_code<=0;flags<=0;
   diagnostic_count<=0;qualified_count<=0;measurement_count<=0;preview_count<=0;
   measurement_rows<=0;preview_rows<=0;ambiguous_count<=0;sat250_count<=0;sat255_count<=0;
   processing_cycles<=0;input_bytes<=0;measure_status<=5;preview_status<=5;
   bin<=0;pair_phase<=0;pair_first<=0;seed_retry_active<=0;
   measure_median_peak_x2<=0;measure_median_width_x2<=0;
   preview_median_peak_x2<=0;preview_median_width_x2<=0;raw_peak_median_x2<=0;
   frame_measurement_usable<=0;frame_preview_usable<=0;frame_quality_flags<=0;ambiguous_rows<=0;
   addr_a<=0;addr_b<=0;node<=0;pair_y<=1;rp<=rmeta0;rc<=rmeta1;pair_a<=0;pair_b<=0;
   out_y<=0;out_slot<=0;out_record<=0;out_kind<=0;hist_i<=0;hp_key<=0;hp_next<=0;
   edge_reg<=0;edge_delta<=0;edge4_reg<=0;
   for(k=0;k<4;k=k+1)delta4_reg[k]<=0;
   stability_max01<=0;stability_max23<=0;stability_max_all<=0;stability_wb_reg<=0;
   pair_center_a<=0;pair_center_b4<=0;pair_width_a<=0;pair_width_b4<=0;pair_eligible4<=0;
   hm<=0;hp<=0;whm<=0;whp<=0;hr<=0;
  end else if(abort&&busy)begin
   output_eligible_node<=0;output_row_overflow<=0;busy<=0;done<=1;error<=1;error_code<=2;flags<=16;state<=IDLE;clear_row<=1;
   frame_measurement_usable<=0;frame_preview_usable<=0;
  end else begin
   if(busy)processing_cycles<=processing_cycles+1;
   if(pixel_valid&&pixel_ready)begin
    input_bytes<=input_bytes+1;
    if(bin)begin pair_phase<=!pair_phase;pair_first<=pixel_data;end
    if(pixel_sof!=(input_bytes==0)||pixel_eof!=(input_bytes==FRAME_WIDTH*FRAME_HEIGHT-1))begin
     busy<=0;done<=1;error<=1;error_code<=1;flags<=16;state<=IDLE;clear_row<=1;
     frame_measurement_usable<=0;frame_preview_usable<=0;
    end
   end
   case(state)
    IDLE:if(start)begin
     bin<=bin_mode;pair_phase<=0;seed_retry_active<=seed_retry_mode&&!bin_mode;
     output_eligible_node<=0;output_row_overflow<=0;clear_row<=1;busy<=1;error<=0;error_code<=0;flags<=0;state<=INGRESS;
     input_bytes<=0;processing_cycles<=0;measurement_count<=0;preview_count<=0;
     measurement_rows<=0;preview_rows<=0;ambiguous_count<=0;slotted_count<=0;amb_rows<=0;
     low_support_seen<=0;
     frame_measurement_usable<=0;frame_preview_usable<=0;frame_quality_flags<=0;ambiguous_rows<=0;
     row_m<=0;row_p<=0;row_mw<=0;row_pw<=0;row_mp<=0;row_pp<=0;row_amb<=0;
    end
    INGRESS:if(row_done&&!clear_row)begin
     diagnostic_count<=local_raw;qualified_count<=local_qualified;
     sat250_count<=local_sat250;sat255_count<=local_sat255;
     flags<=local_overflow?10:0;node<=0;state<=INIT;hist_i<=0;
    end
    INIT:begin
     if(node<256)begin hp_m[node]<=0;hp_p[node]<=0;hw_m[node]<=0;hw_p[node]<=0;hp_raw[node]<=0;end
     if(node==((N>256?N:256)-1))begin pass<=0;pair_y<=1;rp<=rmeta0;rc<=rmeta1;pair_a<=0;pair_b<=0;
      if(FRAME_HEIGHT==1)begin node<=0;state<=LABEL_ADDR;end else state<=PAIR_ADDR;
     end else node<=node+1;
    end
    PAIR_ADDR:begin
     // All descriptors of either an overflow row or an empty row are already
     // excluded by eligible_a/eligible_b in V9. Skip their work, NOT the gate.
     if(SPARSE_GRAPH && (rp[5] || rc[5] ||
        rp[4:0]==0 || rc[4:0]==0))begin
      pair_a<=0;pair_b<=0;
      if(pair_y==FRAME_HEIGHT-1)begin
       pair_y<=1;rp<=rmeta0;rc<=rmeta1;
       if(pass==2)begin node<=0;state<=LABEL_ADDR;end
       else begin pass<=pass+1;state<=PAIR_ADDR;end
      end else begin pair_y<=pair_y+1;rp<=rc;rc<=rmeta_next;state<=PAIR_ADDR;end
     end else begin
      addr_a<=(pair_y-1)*16+pair_a;addr_b<=pair_y*16+pair_b;state<=PAIR_WAIT;
     end
    end
    PAIR_WAIT:state<=PAIR_LATCH;
    PAIR_LATCH:begin
     pair_center_a<=da[39:18];pair_width_a<=da[49:40];
     for(k=0;k<4;k=k+1)begin
      pair_center_b4[k*22+:22]<=desc_b4[k*96+18+:22];
      pair_width_b4[k*10+:10]<=desc_b4[k*96+40+:10];
      pair_eligible4[k]<=eligible_a&&(pair_b+k)<rc[4:0]&&!rc[5];
     end
     state<=PAIR_COMPARE;
    end
    PAIR_COMPARE:begin
     edge4_reg<=edge4;
     for(k=0;k<4;k=k+1)delta4_reg[k]<=delta4[k];
     state<=pass==2?PAIR_REDUCE0:PAIR_APPLY;
    end
    PAIR_REDUCE0:begin
     stability_max01<=stable_d0>stable_d1?stable_d0:stable_d1;
     stability_max23<=stable_d2>stable_d3?stable_d2:stable_d3;
     stability_wb_reg<=stability_wb;
     state<=PAIR_REDUCE1;
    end
    PAIR_REDUCE1:begin
     stability_max_all<=stability_max01>stability_max23?stability_max01:stability_max23;
     state<=PAIR_APPLY;
    end
    PAIR_APPLY:begin
     if(SPARSE_GRAPH ? (({1'b0,pair_b}+5'd4)>=rc[4:0]) : pair_b==12)begin pair_b<=0;
      if(SPARSE_GRAPH ? (({1'b0,pair_a}+5'd1)>=rp[4:0]) : pair_a==15)begin pair_a<=0;
       if(pair_y==FRAME_HEIGHT-1)begin
        pair_y<=1;rp<=rmeta0;rc<=rmeta1;
        if(pass==2)begin node<=0;state<=LABEL_ADDR;end
        else begin pass<=pass+1;state<=PAIR_ADDR;end
       end else begin pair_y<=pair_y+1;rp<=rc;rc<=rmeta_next;state<=PAIR_ADDR;end
      end else begin pair_a<=pair_a+1;state<=PAIR_ADDR;end
     end else begin pair_b<=pair_b+4;state<=PAIR_ADDR;end
    end
    LABEL_ADDR:begin addr_a<=node;state<=LABEL_WAIT;end
    LABEL_WAIT:state<=LABEL_PRED;
    LABEL_PRED:begin
     if(eligible_node&&!ama)begin
      if(pca==1)begin addr_b<=pra;state<=LABEL_PWAIT;end
      else begin root_id<=node;addr_b<=node;state<=LABEL_RWAIT;end
     end else begin
      if(node==N-1)begin node<=0;out_y<=0;out_slot<=0;state<=OUT_ADDR;end
      else begin node<=node+1;state<=LABEL_ADDR;end
     end
    end
    LABEL_PWAIT:state<=LABEL_ROOT;
    LABEL_ROOT:begin
     if(!amb&&lb!=13'h1fff)begin root_id<=lb;addr_b<=lb;end
     else begin root_id<=node;addr_b<=node;end
     state<=LABEL_RWAIT;
    end
    LABEL_RWAIT:state<=LABEL_WRITE;
    LABEL_WRITE:begin
     if(node==N-1)begin node<=0;out_y<=0;out_slot<=0;state<=OUT_ADDR;end
     else begin node<=node+1;state<=LABEL_ADDR;end
    end
    OUT_ADDR:begin output_eligible_node<=eligible_node;output_row_overflow<=rows[node>>4][8];
     hp_key<=rows[out_y][39:32];addr_a<=node;state<=OUT_WAIT;end
    OUT_WAIT:begin hp_next<=hp_raw[hp_key]+1'b1;state<=OUT_ROOT;end
    OUT_ROOT:begin
     held_desc<=da;
     if(node[3:0]<rows[out_y][4:0])begin
      slotted_count<=slotted_count+1;
      if(ama)begin ambiguous_count<=ambiguous_count+1;row_amb<=1;end
      addr_b<=la;state<=OUT_RWAIT;
     end else begin
      if(node[3:0]==15)begin state<=ROW_SEND;out_kind<=2;out_record<=0;
       out_record[31:0]<=out_y;out_record[63:32]<=rows[out_y][63:32];
       out_record[95:64]<=rows[out_y][95:64];out_record[127:96]<=rows[out_y][127:96];
       out_record[159:128]<=rows[out_y][159:128];out_record[191:160]<=rows[out_y][191:160];
       out_record[223:192]<=row_m;out_record[255:224]<=row_p;out_record[287:256]<=row_mw;
       out_record[319:288]<=row_pw;out_record[351:320]<=row_mp;out_record[383:352]<=row_pp;
       out_record[415:384]<=row_amb;out_record[447:416]<=row_amb;
      end else begin node<=node+1;state<=OUT_ADDR;end
     end
    end
    OUT_RWAIT:state<=OUT_QUALIFY;
    OUT_QUALIFY:begin
     // addr_b was issued in OUT_ROOT. OUT_RWAIT supplies the synchronous
     // RAM latency; capture here on the same edge used by the old OUT_BUILD.
     can_p<=next_can_p;can_m<=next_can_m;
     reason_p<=next_reason_p;reason_m<=next_reason_m;
     state<=OUT_BUILD;
    end
    OUT_BUILD:begin
     if(output_eligible_node&&!ama&&sub<3)low_support_seen<=1;
     out_record<=0;out_kind<=1;
     out_record[31:0]<=held_desc[17:0];
     out_record[447:416]<={5'b0,can_p,can_m,1'b1,reason_p,reason_m,8'b0};
     out_record[479:448]<={(can_p?{3'b0,la}:16'hffff),(can_m?{3'b0,la}:16'hffff)};
     out_record[503:480]<=sta;
     if(can_m)begin
      measurement_count<=measurement_count+1;row_m<=row_m+1;
      if(held_desc[49:40]>row_mw)row_mw<=held_desc[49:40];
      if(held_desc[77:70]>row_mp)row_mp<=held_desc[77:70];
      hp_m[held_desc[77:70]]<=hp_m[held_desc[77:70]]+1;
      hw_m[held_desc[49:40]]<=hw_m[held_desc[49:40]]+1;
     end
     if(can_p)begin
      preview_count<=preview_count+1;row_p<=row_p+1;
      if(held_desc[49:40]>row_pw)row_pw<=held_desc[49:40];
      if(held_desc[77:70]>row_pp)row_pp<=held_desc[77:70];
      hp_p[held_desc[77:70]]<=hp_p[held_desc[77:70]]+1;
      hw_p[held_desc[49:40]]<=hw_p[held_desc[49:40]]+1;
     end
     state<=OUT_SEND;
    end
    OUT_SEND:if(record_ready)begin
     if(node[3:0]==15)begin state<=ROW_SEND;out_kind<=2;out_record<=0;
      out_record[31:0]<=out_y;out_record[63:32]<=rows[out_y][63:32];
      out_record[95:64]<=rows[out_y][95:64];out_record[127:96]<=rows[out_y][127:96];
      out_record[159:128]<=rows[out_y][159:128];out_record[191:160]<=rows[out_y][191:160];
      out_record[223:192]<=row_m;out_record[255:224]<=row_p;out_record[287:256]<=row_mw;
      out_record[319:288]<=row_pw;out_record[351:320]<=row_mp;out_record[383:352]<=row_pp;
      out_record[415:384]<=row_amb;out_record[447:416]<=row_amb;
     end else begin node<=node+1;state<=OUT_ADDR;end
    end
    ROW_SEND:if(record_ready)begin
     if(row_m!=0)measurement_rows<=measurement_rows+1;
     if(row_p!=0)preview_rows<=preview_rows+1;
     if(row_amb)amb_rows<=amb_rows+1;
     hp_raw[hp_key]<=hp_next;
     row_m<=0;row_p<=0;row_mw<=0;row_pw<=0;row_mp<=0;row_pp<=0;row_amb<=0;
     if(out_y==FRAME_HEIGHT-1)begin hist_i<=0;cm<=0;cp<=0;wm<=0;wp<=0;cr<=0;
      mplo<=0;mphi<=0;pplo<=0;pphi<=0;mwlo<=0;mwhi<=0;pwlo<=0;pwhi<=0;rlo<=0;rhi<=0;
      state<=HIST_READ;
     end else begin out_y<=out_y+1;node<=node+1;state<=OUT_ADDR;end
    end
    HIST_READ:begin
     hm<=hp_m[hist_i];hp<=hp_p[hist_i];whm<=hw_m[hist_i];whp<=hw_p[hist_i];hr<=hp_raw[hist_i];
     state<=HIST;
    end
    HIST:begin
     if(cm<=((measurement_count-1)>>1)&&cm+hm>((measurement_count-1)>>1))mplo<=hist_i;
     if(cm<=(measurement_count>>1)&&cm+hm>(measurement_count>>1))mphi<=hist_i;
     if(cp<=((preview_count-1)>>1)&&cp+hp>((preview_count-1)>>1))pplo<=hist_i;
     if(cp<=(preview_count>>1)&&cp+hp>(preview_count>>1))pphi<=hist_i;
     if(wm<=((measurement_count-1)>>1)&&wm+whm>((measurement_count-1)>>1))mwlo<=hist_i;
     if(wm<=(measurement_count>>1)&&wm+whm>(measurement_count>>1))mwhi<=hist_i;
     if(wp<=((preview_count-1)>>1)&&wp+whp>((preview_count-1)>>1))pwlo<=hist_i;
     if(wp<=(preview_count>>1)&&wp+whp>(preview_count>>1))pwhi<=hist_i;
     if(cr<=((FRAME_HEIGHT-1)>>1)&&cr+hr>((FRAME_HEIGHT-1)>>1))rlo<=hist_i;
     if(cr<=(FRAME_HEIGHT>>1)&&cr+hr>(FRAME_HEIGHT>>1))rhi<=hist_i;
     cm<=cm+hm;cp<=cp+hp;wm<=wm+whm;wp<=wp+whp;cr<=cr+hr;
     if(hist_i==255)state<=FINISH;else begin hist_i<=hist_i+1;state<=HIST_READ;end
    end
    FINISH:begin
     frame_preview_usable<=preview_count!=0;
     frame_measurement_usable<=measurement_count>=8&&measurement_rows*4>=FRAME_HEIGHT&&
       sat250_count*1000<=FRAME_WIDTH*FRAME_HEIGHT&&ambiguous_count*10<=slotted_count;
     frame_quality_flags<=(preview_count==0?1:0)|
       ((measurement_count>=8&&measurement_rows*4>=FRAME_HEIGHT&&sat250_count*1000<=FRAME_WIDTH*FRAME_HEIGHT&&ambiguous_count*10<=slotted_count)?0:2)|
       (local_overflow?4:0)|(ambiguous_count!=0?8:0)|(sat250_count!=0?16:0)|(border_seen?32:0)|(low_support_seen?64:0);
     ambiguous_rows<=amb_rows;
     measure_median_peak_x2<=mplo+mphi;measure_median_width_x2<=mwlo+mwhi;
     preview_median_peak_x2<=pplo+pphi;preview_median_width_x2<=pwlo+pwhi;raw_peak_median_x2<=rlo+rhi;
     if(sat250_count*1000>FRAME_WIDTH*FRAME_HEIGHT)begin measure_status<=1;preview_status<=1;end
     else if(ambiguous_count*10>slotted_count)begin measure_status<=2;preview_status<=2;end
     else begin
      measure_status<=measurement_count==0?3:((measurement_count>=8&&measurement_rows*4>=FRAME_HEIGHT)?0:4);
      preview_status<=preview_count==0?3:0;
     end
     flags<=flags|1;node<=0;state<=G_ADDR;
    end
    G_ADDR:begin addr_a<=node;state<=G_WAIT;end
    G_WAIT:begin state<=G_SEND;held_desc<=0;geometry_captured<=0;end
    G_SEND:begin
     // Synchronous descriptor read: one explicit capture cycle, followed by a
     // stable ready/valid transaction. Unused slots are skipped, never emitted.
     if(!geometry_captured)begin
      if(node[3:0]<rows[node>>4][4:0])begin held_desc<=da;geometry_captured<=1;end
      else if(node==N-1)begin busy<=0;done<=1;state<=IDLE;end
      else begin node<=node+1'b1;state<=G_ADDR;end
     end else if(geometry_modes==0||geometry_ready)begin
      if(node==N-1)begin busy<=0;done<=1;state<=IDLE;end
      else begin node<=node+1'b1;state<=G_ADDR;end
     end
    end
    default:state<=IDLE;
   endcase
  end
 end
endmodule
