ForrestKang/fpga-line-laser-3d-measurement/(commit log)

2026-11-02 Document and assemble the complete PYNQ measurement system for handoff
    [motor_interface.json, t02_scan.stl, vase_scan.stl]
2026-11-02 Validate portable skill across independent models and clarify DMA wait states
2026-11-03 Normalize RTL modules and synchronize build and driver references
